ja1umi/MUTIF1613Project/README.md

# MUTIF1613Project
This project aims to build a vintage PANAFACOM's 16-bit MN1613-based computer. All the project-related files are available here.
