ja1umi/MUTIF1613Project/mutif1613/mutif1613_schematic.pdf

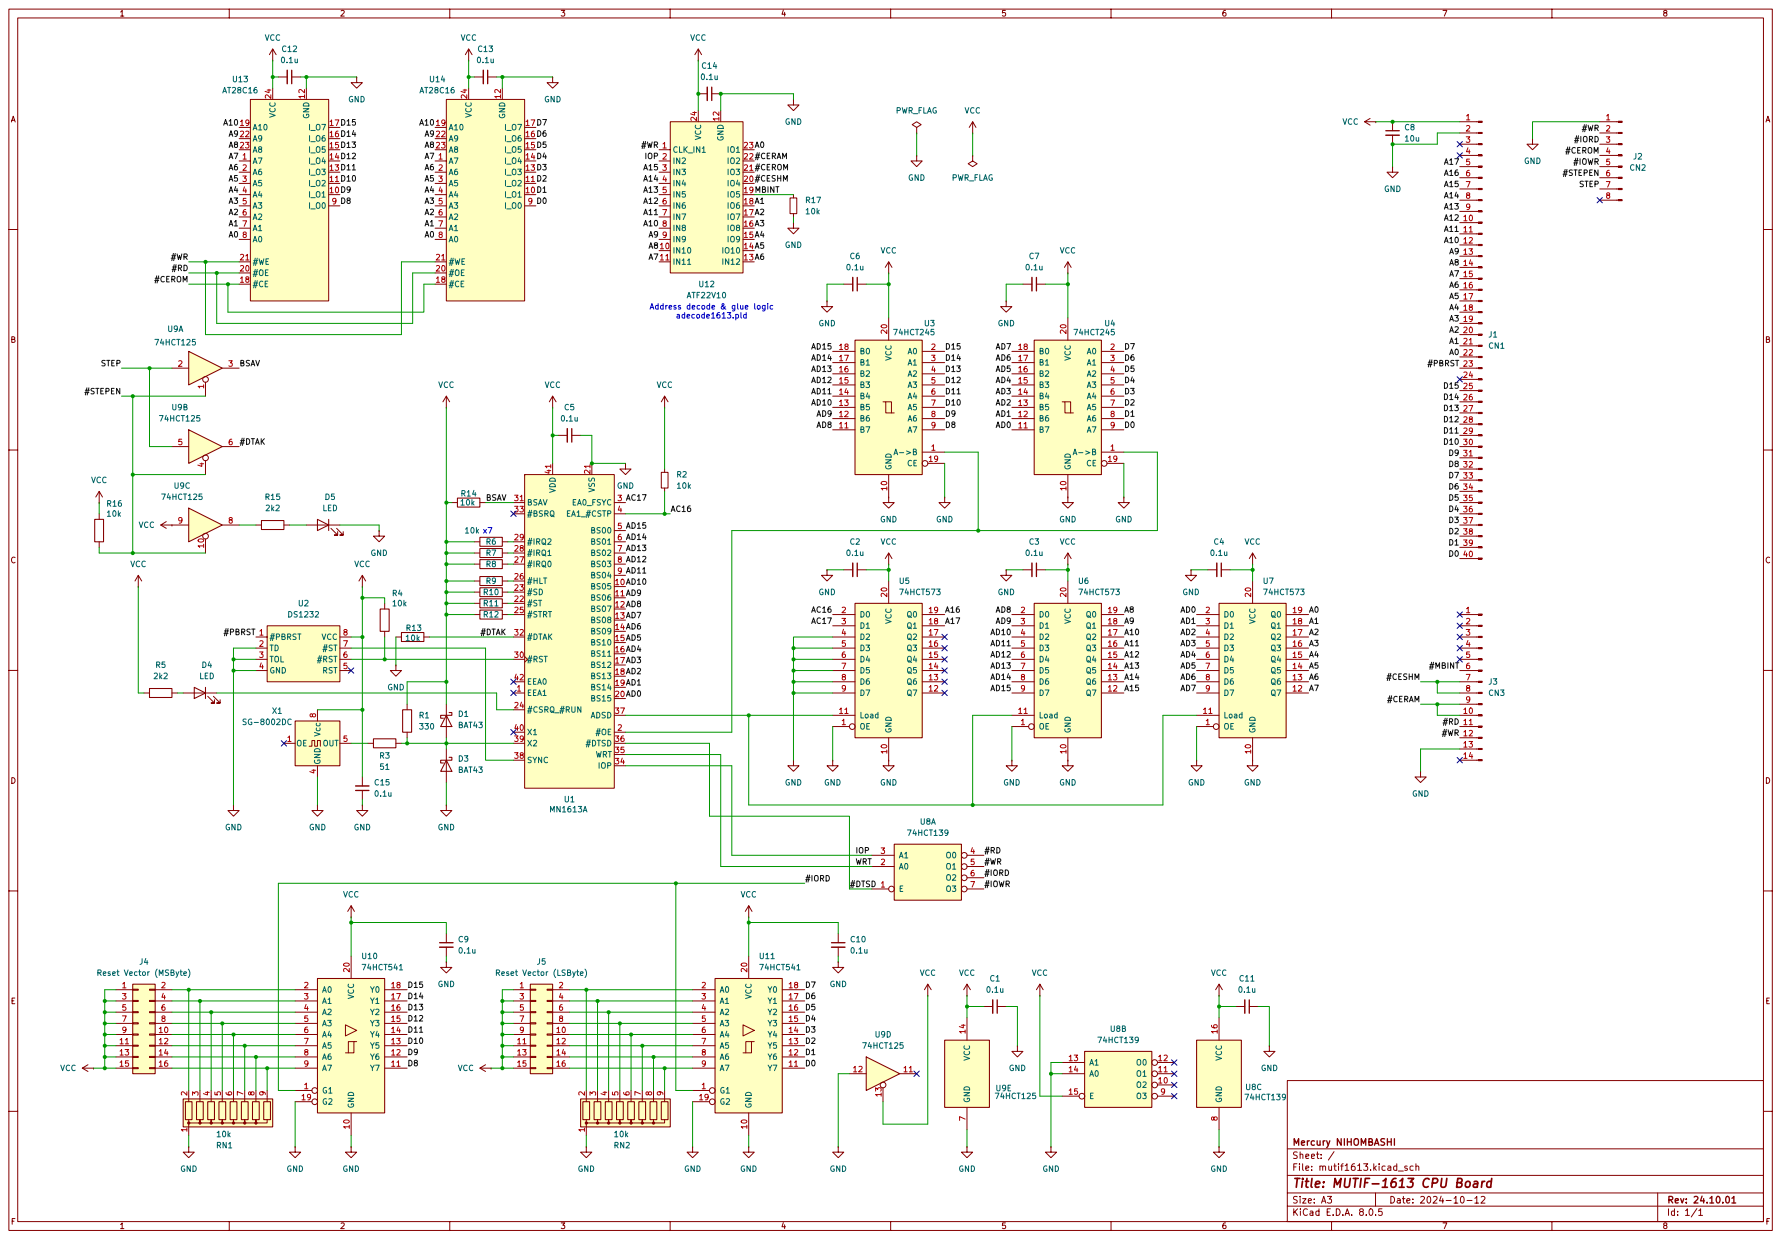
[picture p1: page 1]
