ja1umi/MUTIF1613Project/7segled/7segled-24_11_2.pdf

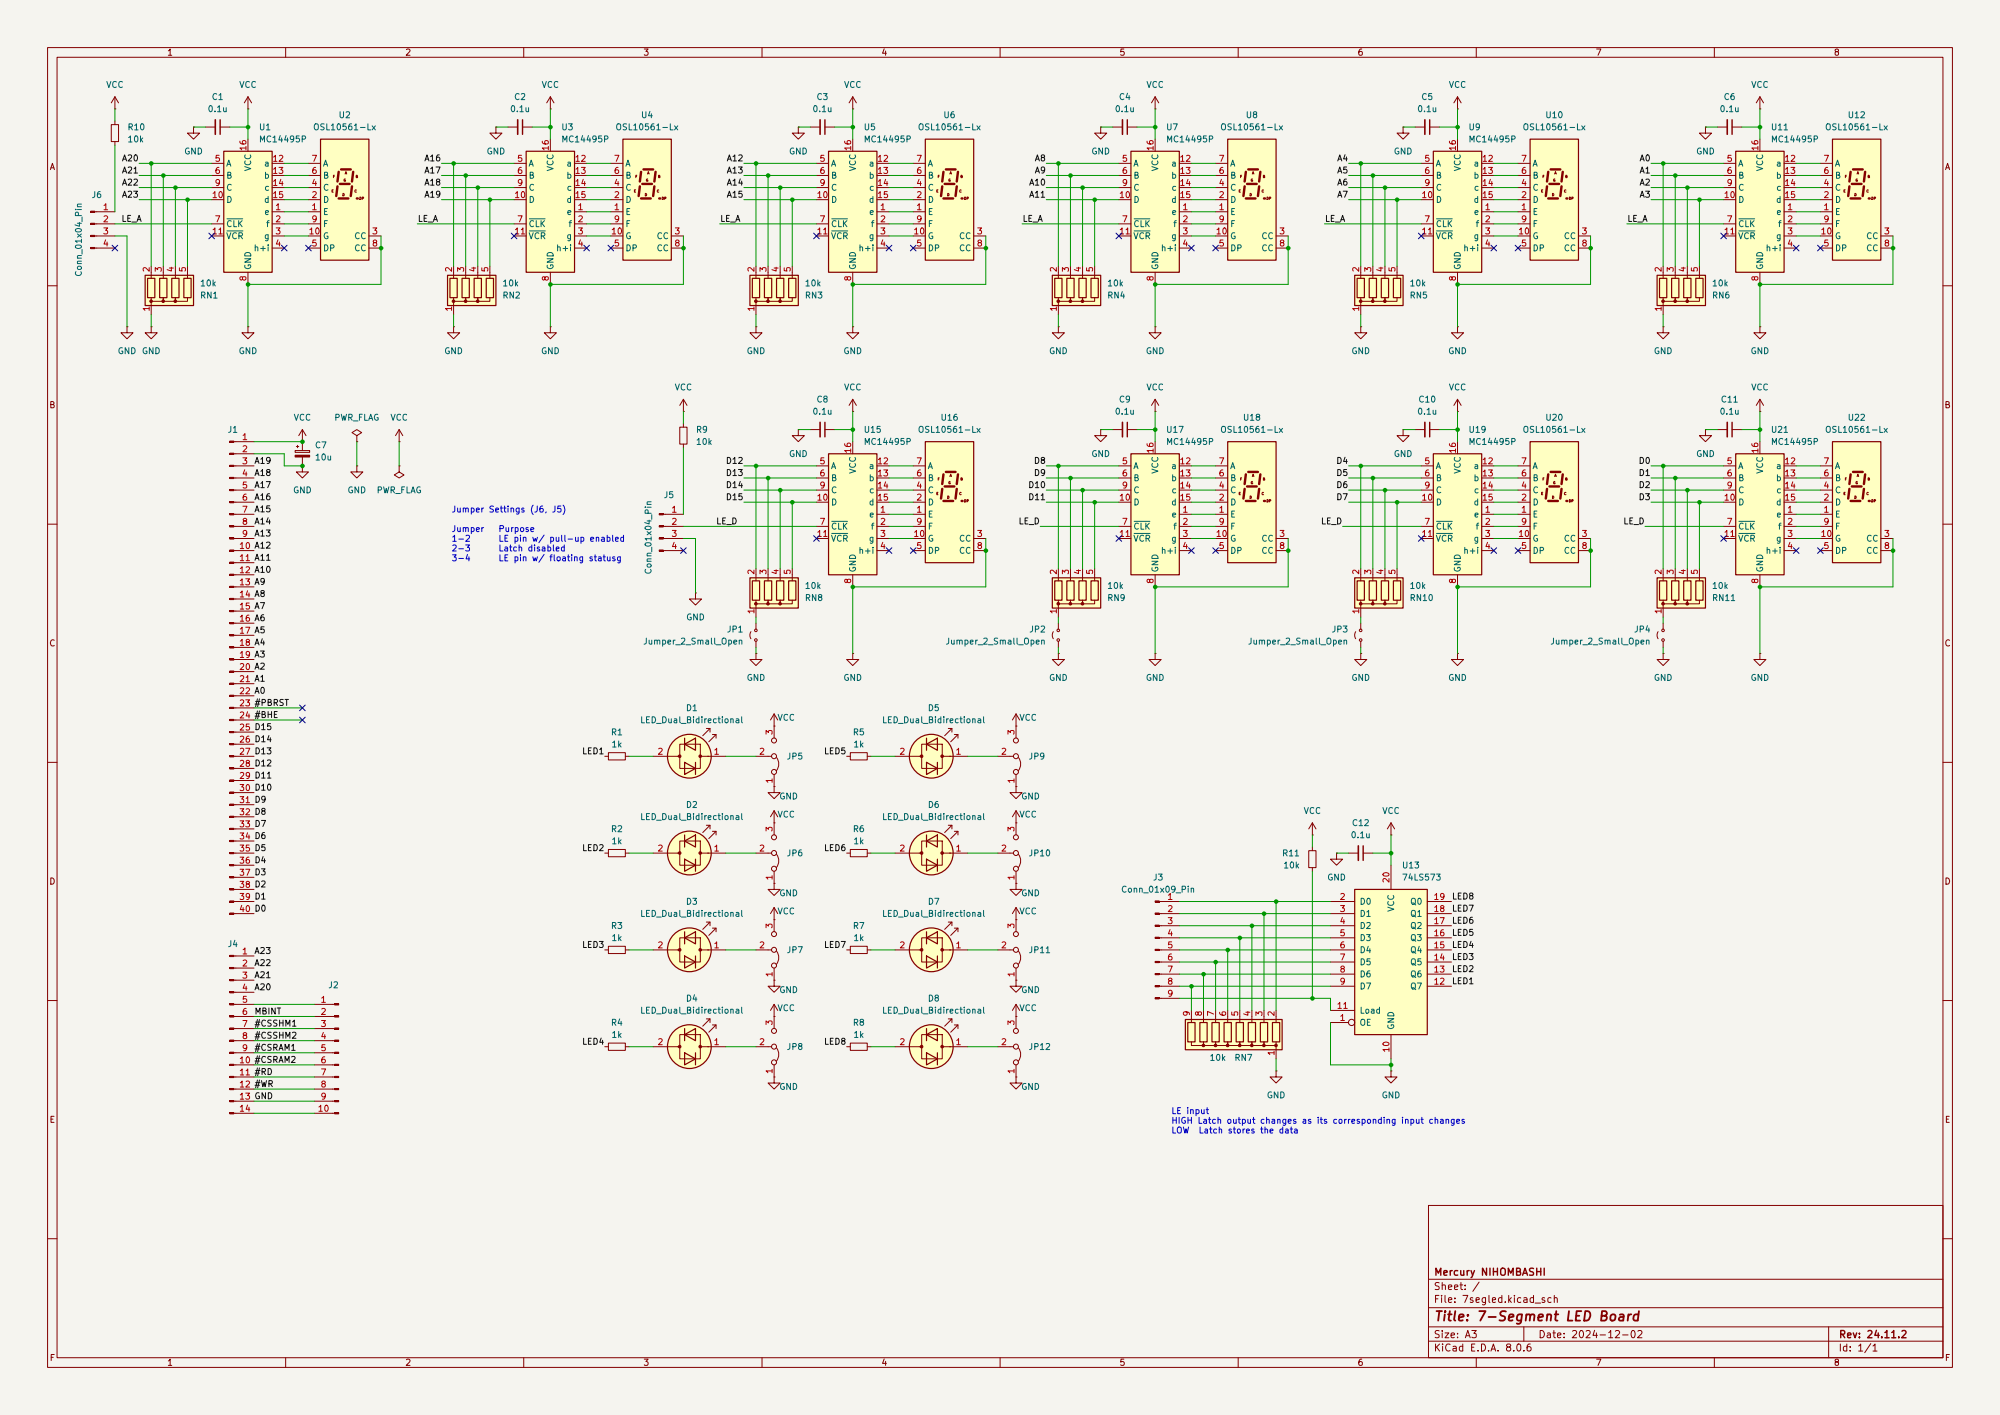
[picture p2: page 1]
