ja1umi/MUTIF1613Project/backplane5/mutif-backplane5-24_11_2.pdf

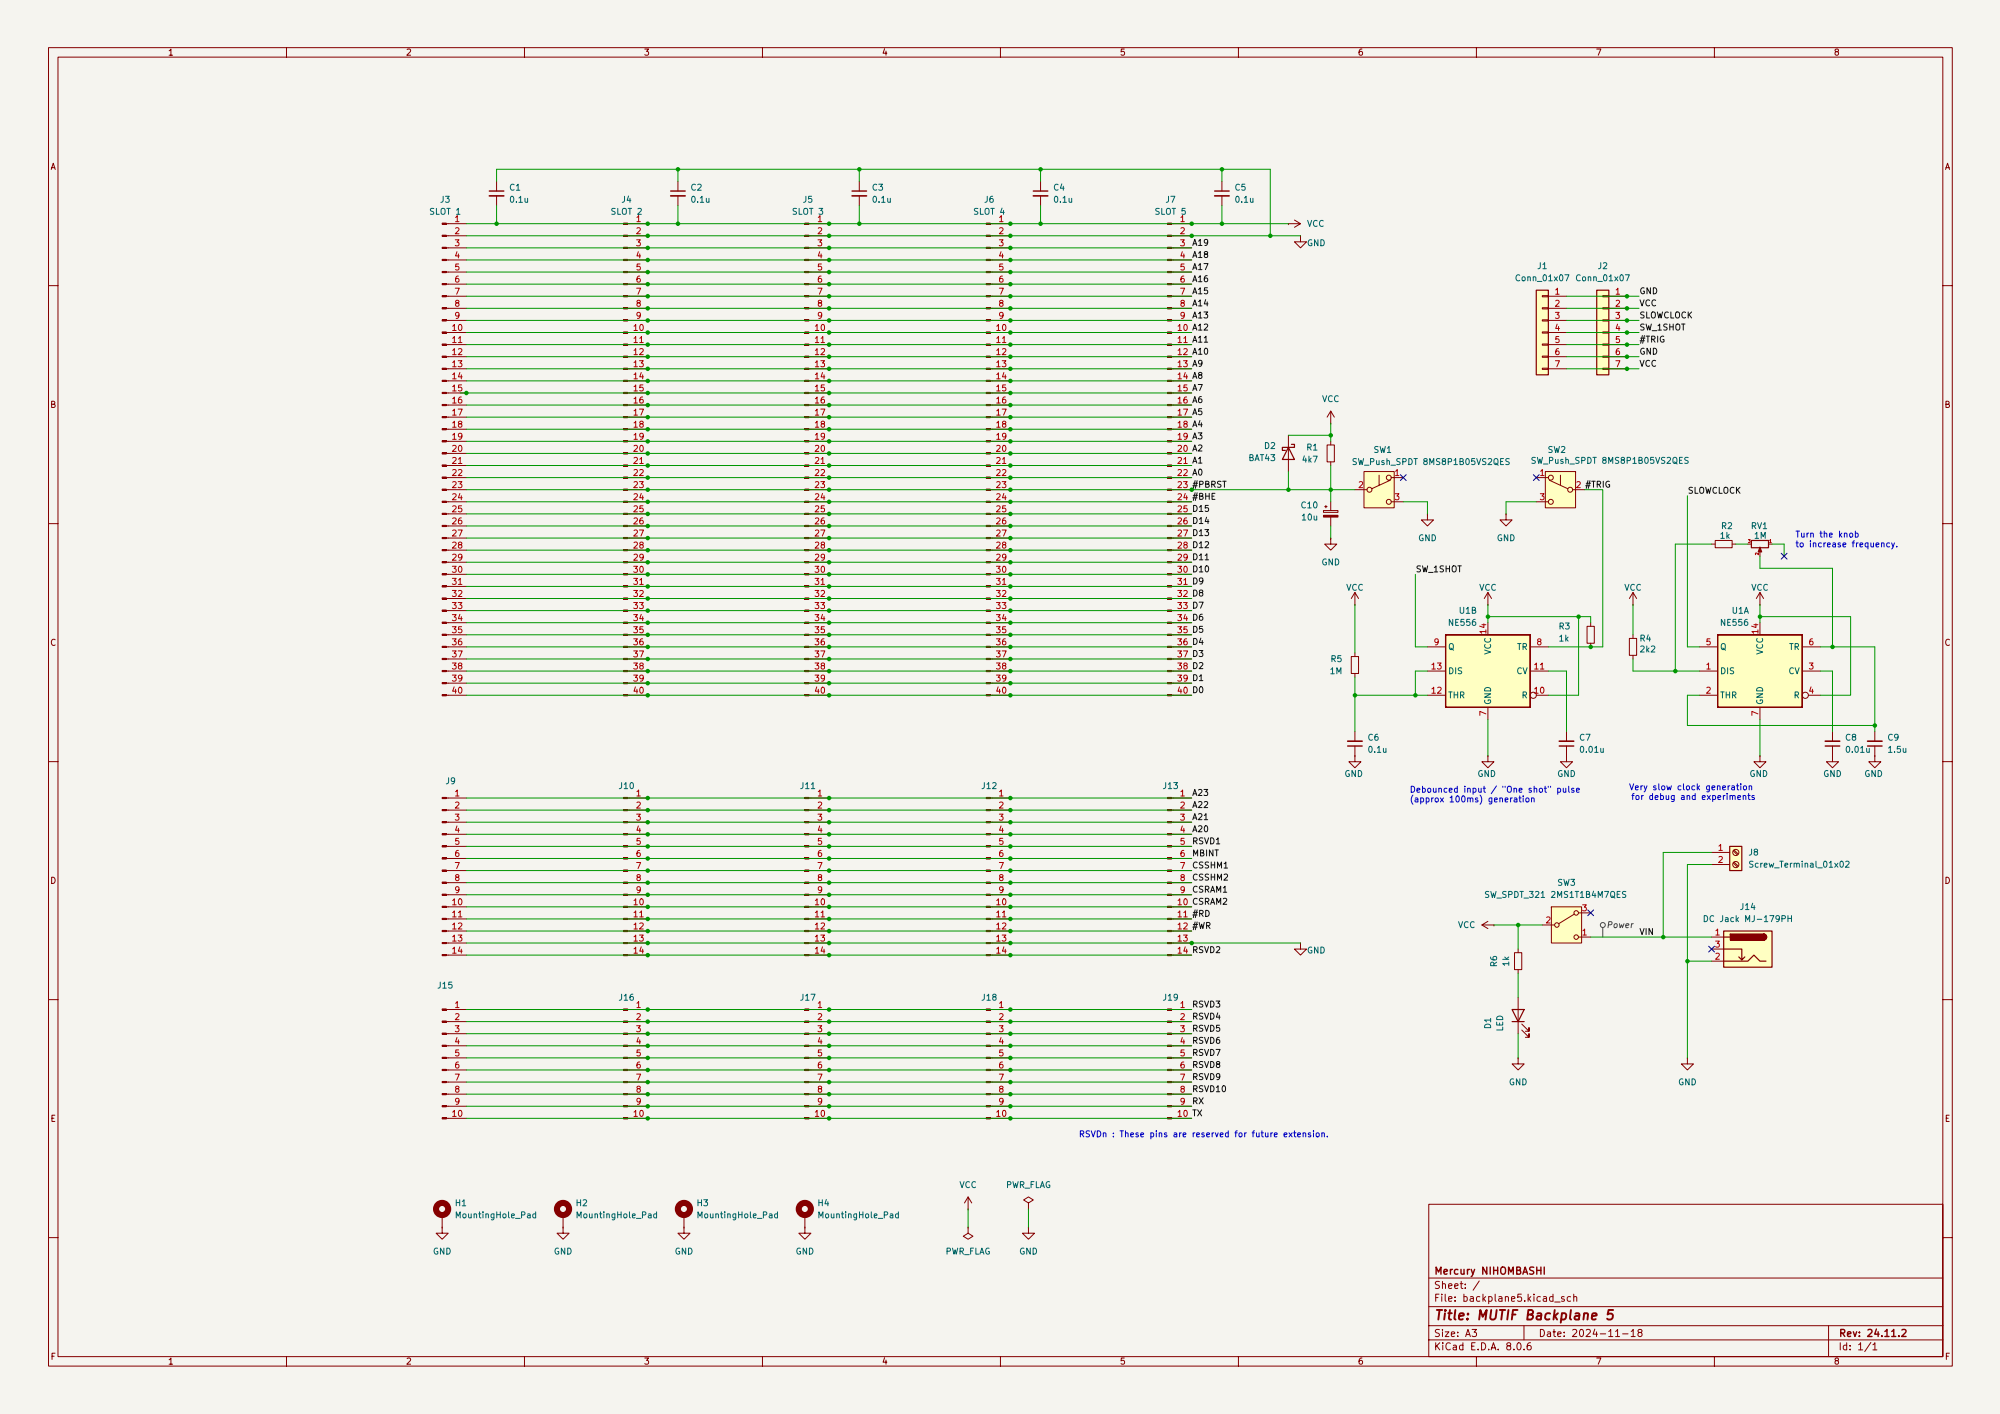
[picture p3: page 1]
