ja1umi/MUTIF1613Project/dpram7134/dpram7134-24_11_1.pdf

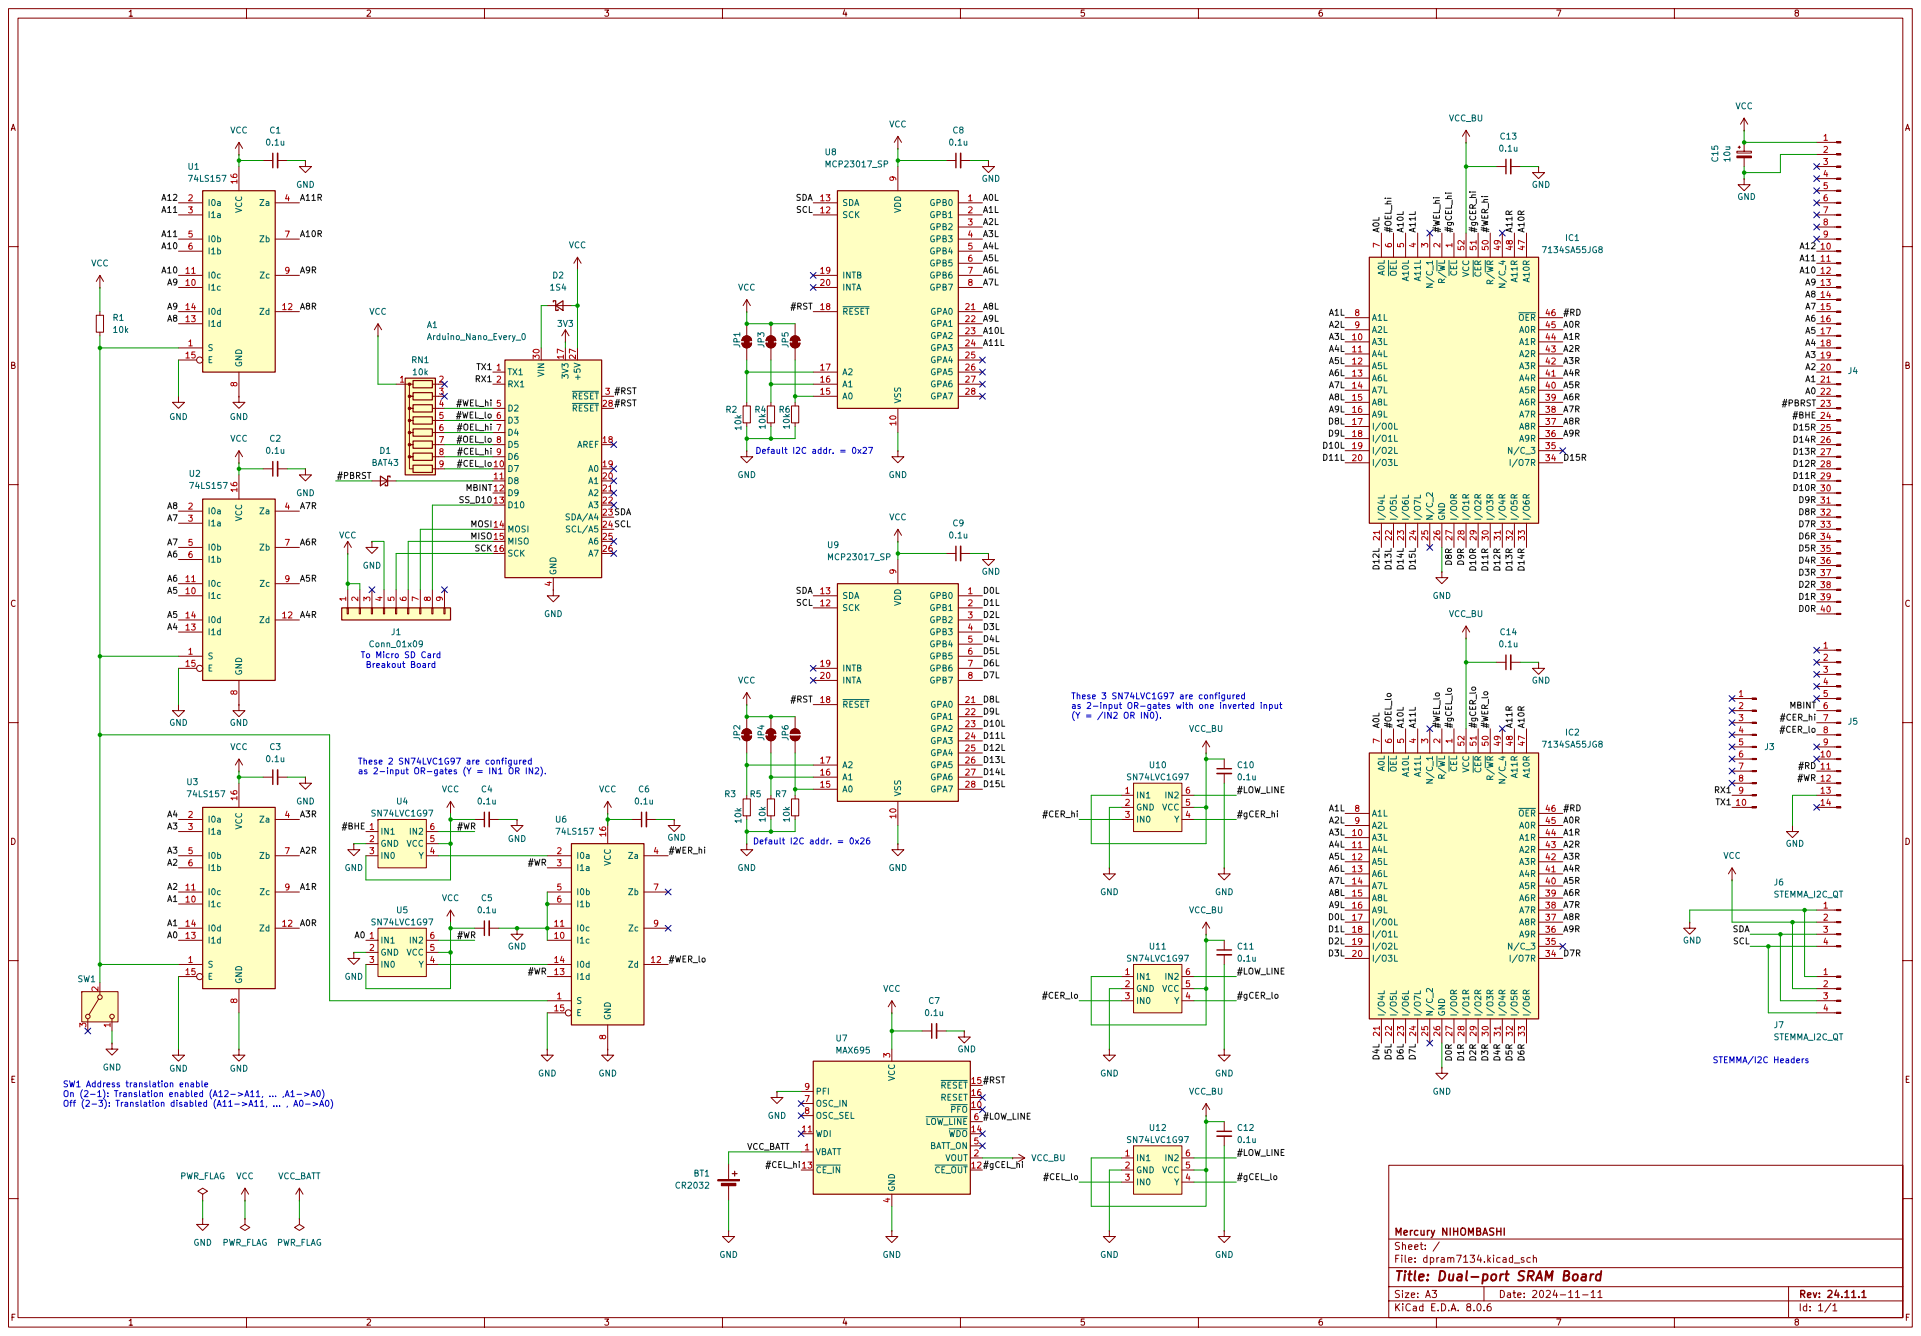
[picture p4: page 1]
