ja1umi/MUTIF1613Project/backplane5/backplane5.kicad_pcb

## KiCad design backplane5/backplane5.kicad_pcb (2024-12-31)

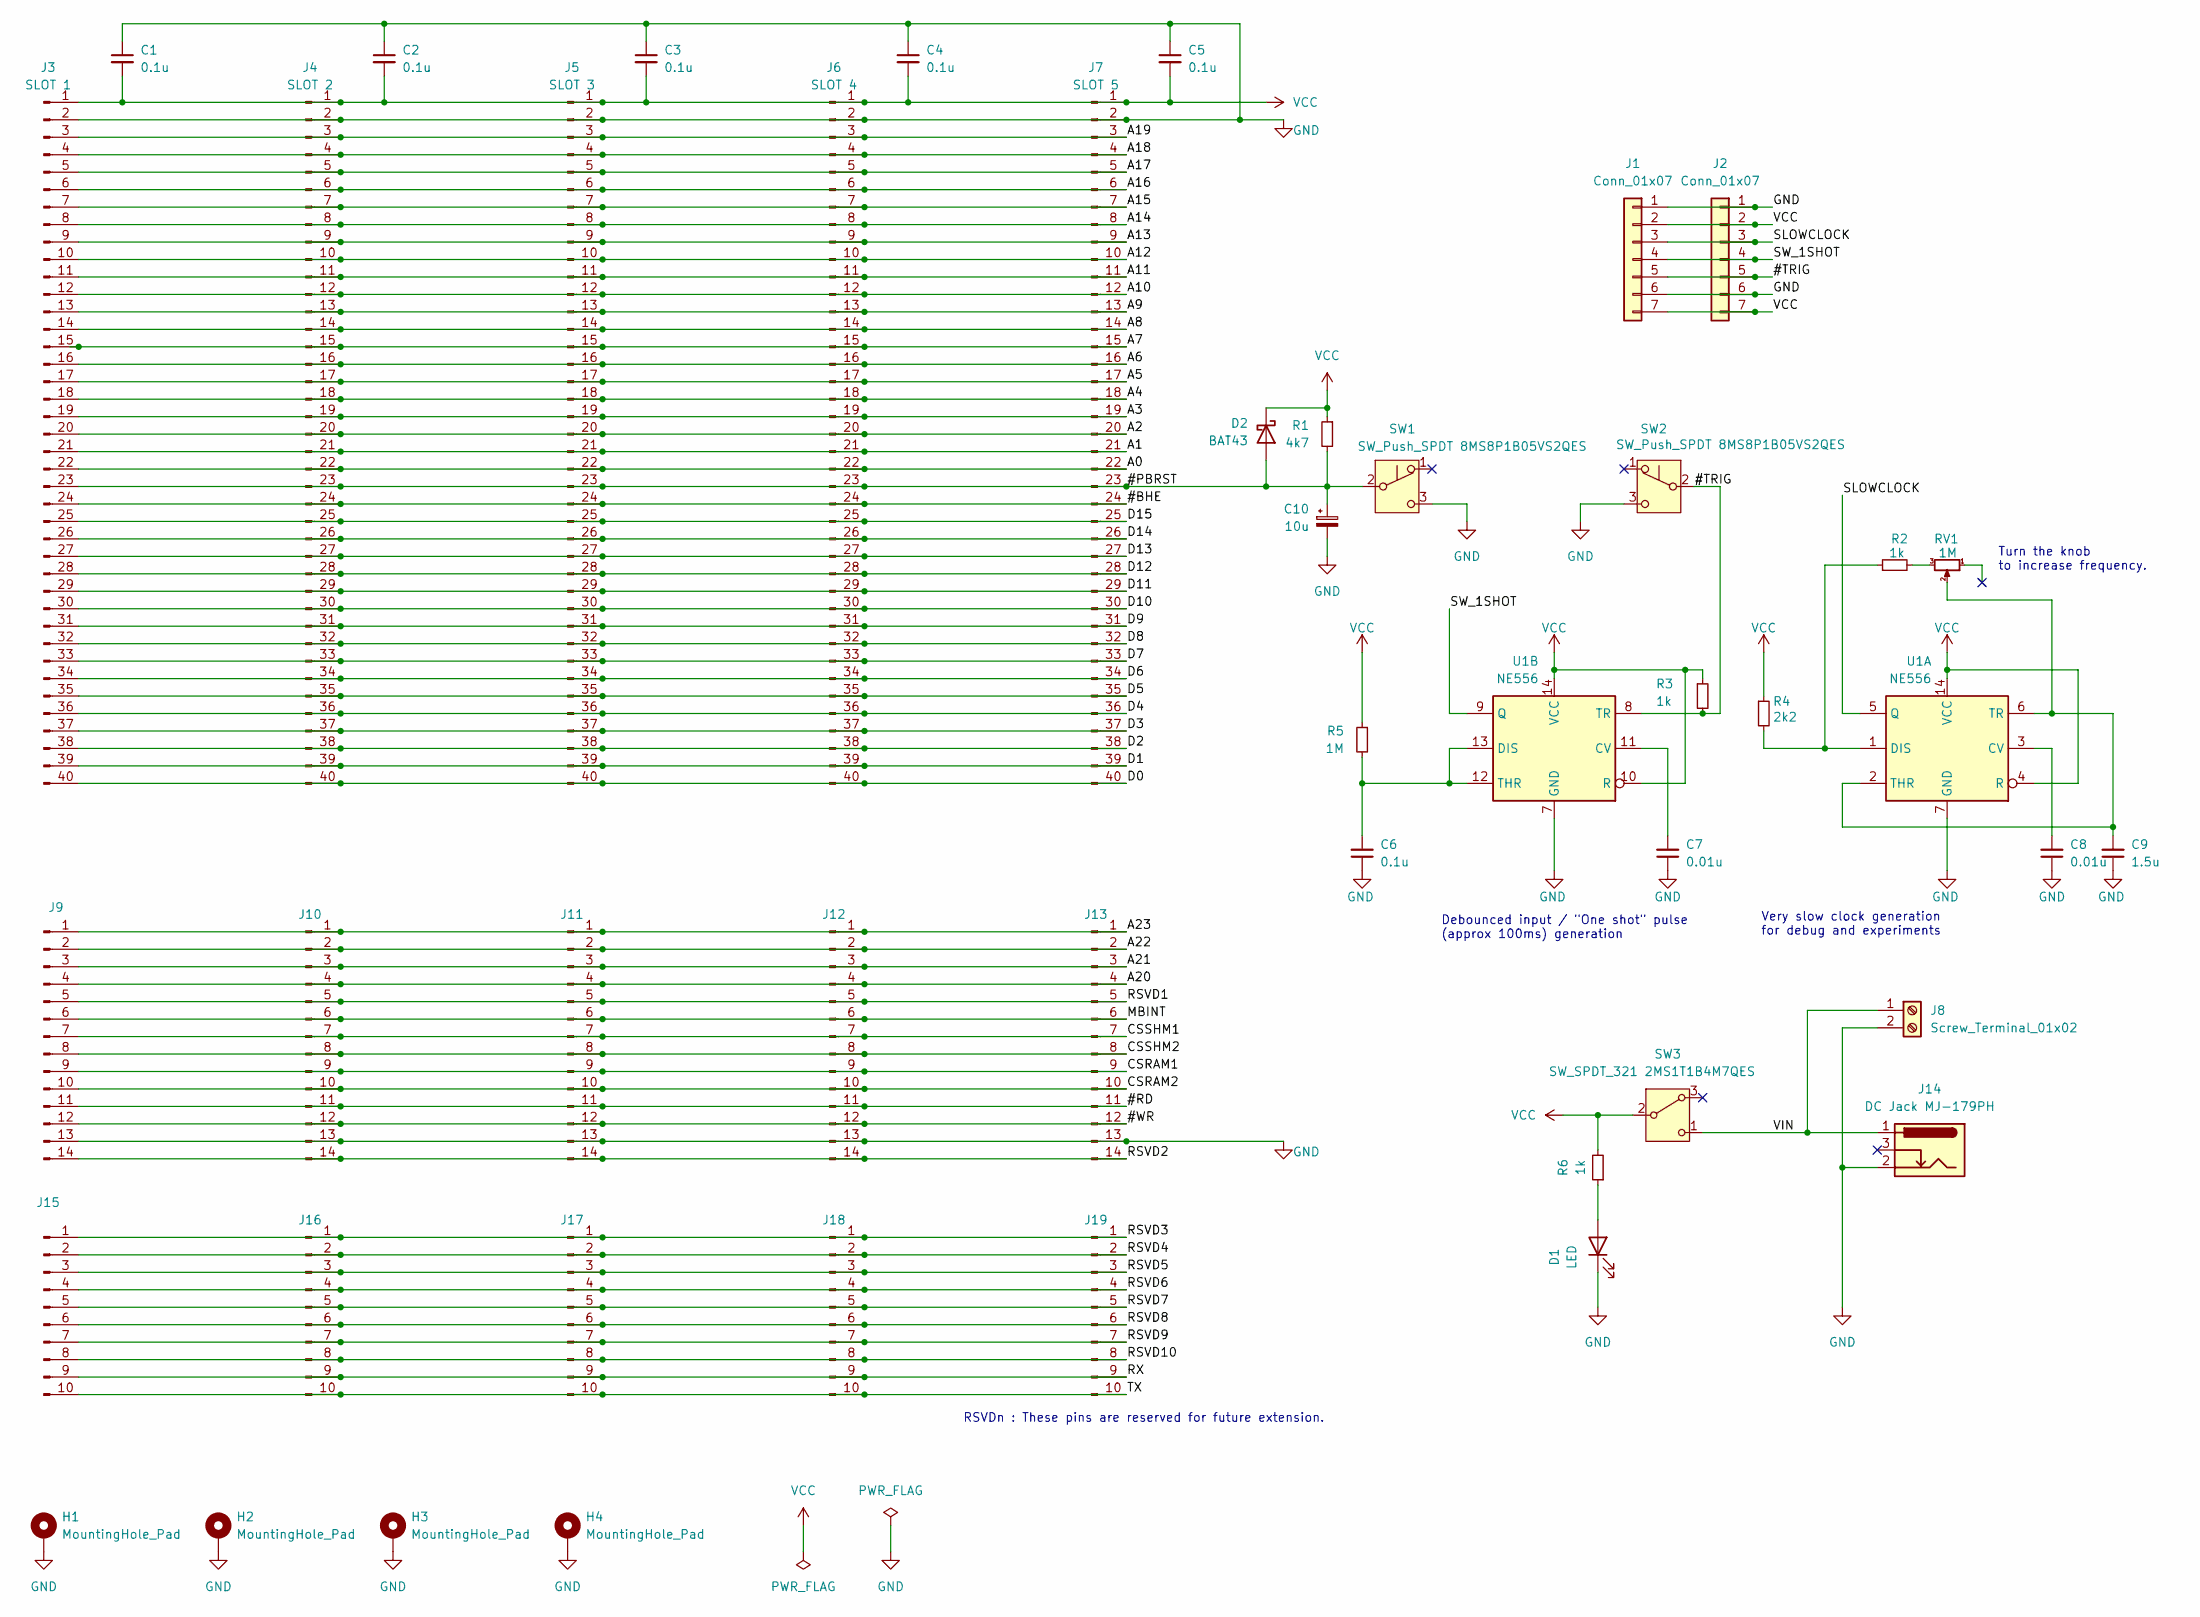
[picture p5: schematic backplane5.kicad_sch, MUTIF Backplane 5]

Parts:
C1, C2, C3, C4, C5, C6: 0.1u; C_Disc_D5.0mm_W2.5mm_P2.50mm
C7, C8: 0.01u; C_Disc_D5.0mm_W2.5mm_P2.50mm
C9: 1.5u; C_Disc_D5.0mm_W2.5mm_P5.00mm
C10: 10u; CP_Radial_D5.0mm_P2.50mm
D1: LED; LED_D5.0mm
D2: BAT43; D_DO-35_SOD27_P7.62mm_Horizontal
H1, H2, H3, H4: MountingHole_Pad; MountingHole_3.2mm_M3_Pad
J1, J2: Conn_01x07; PinHeader_1x07_P2.54mm_Vertical
J3: SLOT 1; PinHeader_1x40_P2.54mm_Vertical
J4: SLOT 2; PinHeader_1x40_P2.54mm_Vertical
J5: SLOT 3; PinHeader_1x40_P2.54mm_Vertical
J6: SLOT 4; PinHeader_1x40_P2.54mm_Vertical
J7: SLOT 5; PinHeader_1x40_P2.54mm_Vertical
J8: Screw_Terminal_01x02; TerminalBlock_Phoenix_MKDS-1,5-2-5.08_1x02_P5.08mm_Horizont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
J9, J10, J11, J12, J13: Conn_01x14_Pin; PinHeader_1x14_P2.54mm_Vertical
J14: DC Jack MJ-179PH; MJ-179PH
J15, J16, J17, J18, J19: Conn_01x10_Pin; PinHeader_1x10_P2.54mm_Vertical
R1: 4k7; R_Axial_DIN0204_L3.6mm_D1.6mm_P7.62mm_Horizontal
R2, R3, R6: 1k; R_Axial_DIN0204_L3.6mm_D1.6mm_P7.62mm_Horizontal
R4: 2k2; R_Axial_DIN0204_L3.6mm_D1.6mm_P7.62mm_Horizontal
R5: 1M; R_Axial_DIN0204_L3.6mm_D1.6mm_P7.62mm_Horizontal
RV1: 1M; Potentiometer_Bourns_3296W_Vertical
SW1, SW2: SW_Push_SPDT 8MS8P1B05VS2QES; 8MSP0340
SW3: SW_SPDT_321 2MS1T1B4M7QES; 2MS1T1B4M7QES
U1: NE556; DIP-14_W7.62mm_LongPads

Connections:
/#BHE: J3.24, J4.24, J5.24, J6.24, J7.24
/#PBRST: C10.1, D2.2 (A), J3.23, J4.23, J5.23, J6.23, J7.23, R1.2, SW1.2 (B)
/#RD: J9.11, J10.11, J11.11, J12.11, J13.11
/#TRIG: J1.5, J2.5, R3.2, SW2.2 (B), U1.8 (TR)
/#WR: J9.12, J10.12, J11.12, J12.12, J13.12
/A0: J3.22, J4.22, J5.22, J6.22, J7.22
/A1: J3.21, J4.21, J5.21, J6.21, J7.21
/A2: J3.20, J4.20, J5.20, J6.20, J7.20
/A3: J3.19, J4.19, J5.19, J6.19, J7.19
/A4: J3.18, J4.18, J5.18, J6.18, J7.18
/A5: J3.17, J4.17, J5.17, J6.17, J7.17
/A6: J3.16, J4.16, J5.16, J6.16, J7.16
/A7: J3.15, J4.15, J5.15, J6.15, J7.15
/A8: J3.14, J4.14, J5.14, J6.14, J7.14
/A9: J3.13, J4.13, J5.13, J6.13, J7.13
/A10: J3.12, J4.12, J5.12, J6.12, J7.12
/A11: J3.11, J4.11, J5.11, J6.11, J7.11
/A12: J3.10, J4.10, J5.10, J6.10, J7.10
/A13: J3.9, J4.9, J5.9, J6.9, J7.9
/A14: J3.8, J4.8, J5.8, J6.8, J7.8
/A15: J3.7, J4.7, J5.7, J6.7, J7.7
/A16: J3.6, J4.6, J5.6, J6.6, J7.6
/A17: J3.5, J4.5, J5.5, J6.5, J7.5
/A18: J3.4, J4.4, J5.4, J6.4, J7.4
/A19: J3.3, J4.3, J5.3, J6.3, J7.3
/A20: J9.4, J10.4, J11.4, J12.4, J13.4
/A21: J9.3, J10.3, J11.3, J12.3, J13.3
/A22: J9.2, J10.2, J11.2, J12.2, J13.2
/A23: J9.1, J10.1, J11.1, J12.1, J13.1
/CSRAM1: J9.9, J10.9, J11.9, J12.9, J13.9
/CSRAM2: J9.10, J10.10, J11.10, J12.10, J13.10
/CSSHM1: J9.7, J10.7, J11.7, J12.7, J13.7
/CSSHM2: J9.8, J10.8, J11.8, J12.8, J13.8
/D0: J3.40, J4.40, J5.40, J6.40, J7.40
/D1: J3.39, J4.39, J5.39, J6.39, J7.39
/D2: J3.38, J4.38, J5.38, J6.38, J7.38
/D3: J3.37, J4.37, J5.37, J6.37, J7.37
/D4: J3.36, J4.36, J5.36, J6.36, J7.36
/D5: J3.35, J4.35, J5.35, J6.35, J7.35
/D6: J3.34, J4.34, J5.34, J6.34, J7.34
/D7: J3.33, J4.33, J5.33, J6.33, J7.33
/D8: J3.32, J4.32, J5.32, J6.32, J7.32
/D9: J3.31, J4.31, J5.31, J6.31, J7.31
/D10: J3.30, J4.30, J5.30, J6.30, J7.30
/D11: J3.29, J4.29, J5.29, J6.29, J7.29
/D12: J3.28, J4.28, J5.28, J6.28, J7.28
/D13: J3.27, J4.27, J5.27, J6.27, J7.27
/D14: J3.26, J4.26, J5.26, J6.26, J7.26
/D15: J3.25, J4.25, J5.25, J6.25, J7.25
/MBINT: J9.6, J10.6, J11.6, J12.6, J13.6
/RSVD1: J9.5, J10.5, J11.5, J12.5, J13.5
/RSVD2: J9.14, J10.14, J11.14, J12.14, J13.14
/RSVD3: J15.1, J16.1, J17.1, J18.1, J19.1
/RSVD4: J15.2, J16.2, J17.2, J18.2, J19.2
/RSVD5: J15.3, J16.3, J17.3, J18.3, J19.3
/RSVD6: J15.4, J16.4, J17.4, J18.4, J19.4
/RSVD7: J15.5, J16.5, J17.5, J18.5, J19.5
/RSVD8: J15.6, J16.6, J17.6, J18.6, J19.6
/RSVD9: J15.7, J16.7, J17.7, J18.7, J19.7
/RSVD10: J15.8, J16.8, J17.8, J18.8, J19.8
/RX: J15.9, J16.9, J17.9, J18.9, J19.9
/SLOWCLOCK: J1.3, J2.3, U1.5 (Q)
/SW_1SHOT: J1.4, J2.4, U1.9 (Q)
/TX: J15.10, J16.10, J17.10, J18.10, J19.10
/VIN: J8.1, J14.1, SW3.1 (C)
GND: C1.1, C2.1, C3.1, C4.1, C5.1, C6.1, C7.1, C8.1, C9.1, C10.2, D1.1 (K), H1.1, H2.1, H3.1, H4.1, J1.1, J1.6, J2.1, J2.6, J3.2, J4.2, J5.2, J6.2, J7.2, J8.2, J9.13, J10.13, J11.13, J12.13, J13.13, J14.2, SW1.3 (C), SW2.3 (C), U1.7 (GND)
unnamed: D1.2 (A), R6.1
unnamed: R2.2, RV1.3
unnamed: C8.2, U1.3 (CV)
unnamed: R2.1, R4.2, U1.1 (DIS)
unnamed: C9.2, RV1.2, U1.2 (THR), U1.6 (TR)
unnamed: C7.2, U1.11 (CV)
unnamed: C6.2, R5.2, U1.12 (THR), U1.13 (DIS)
VCC: C1.2, C2.2, C3.2, C4.2, C5.2, D2.1 (K), J1.2, J1.7, J2.2, J2.7, J3.1, J4.1, J5.1, J6.1, J7.1, R1.1, R3.1, R4.1, R5.1, R6.2, SW3.2 (B), U1.4 (R), U1.10 (R), U1.14 (VCC)

Notes on the sheet:
RSVDn : These pins are reserved for future extension.
Turn the knob to increase frequency.
Very slow clock generation for debug and experiments
Debounced input / "One shot" pulse (approx 100ms) generation

Board: 2 copper layers, 46 parts (0 on the bottom side), 74 nets, no tracks yet.
