ja1umi/MUTIF1613Project/dpram7134/dpram7134.kicad_pcb

## KiCad design dpram7134/dpram7134.kicad_pcb (2024-12-31)

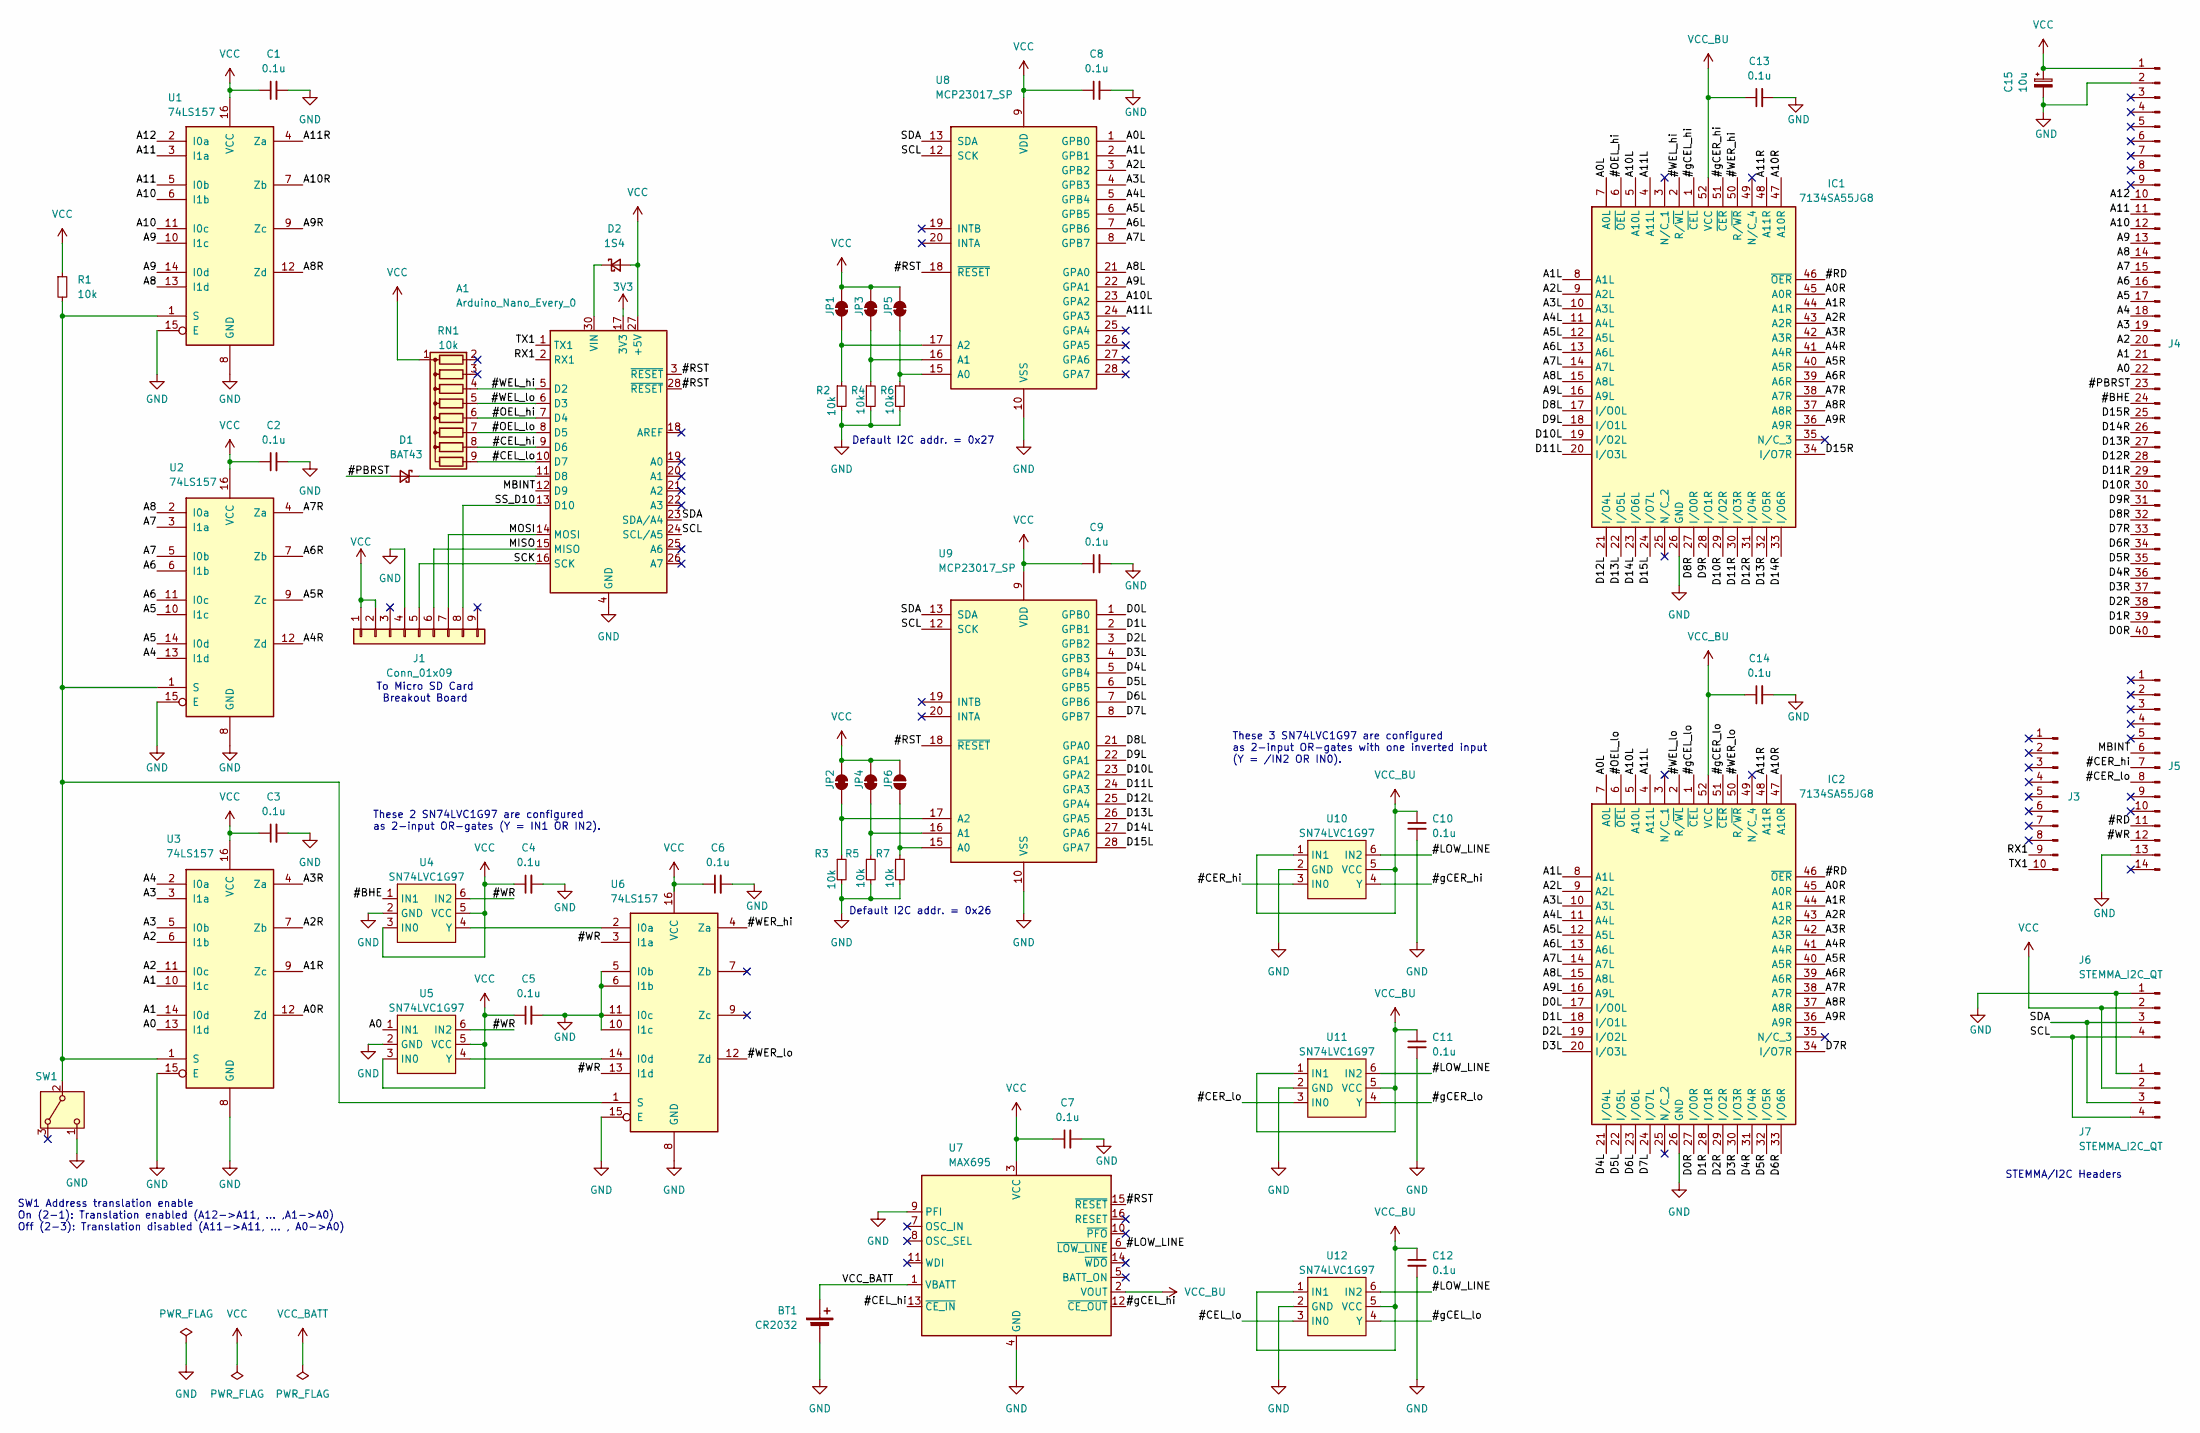
[picture p6: schematic dpram7134.kicad_sch, Dual-port SRAM Board]

Parts:
A1: Arduino_Nano_Every_0; Arduino_Nano
BT1: CR2032; CH243-2032LF
C1, C2, C3, C4, C5, C6, C7, C8, C9, C10, C11, C12, C13, C14: 0.1u; C_Disc_D5.0mm_W2.5mm_P5.00mm
C15: 10u; CP_Radial_D5.0mm_P2.50mm
D1: BAT43; D_DO-35_SOD27_P7.62mm_Horizontal
D2: 1S4; D_DO-35_SOD27_P7.62mm_Horizontal
IC1, IC2: 7134SA55JG8; PLCC-52_THT-Socket; Mouser Part Number 972-7134SA55JG8
J1: Conn_01x09; PinHeader_1x09_P2.54mm_Vertical
J3: Conn_01x10_Pin; PinHeader_1x10_P2.54mm_Vertical
J4: Conn_01x40_Pin; PinHeader_1x40_P2.54mm_Vertical
J5: Conn_01x14_Pin; PinHeader_1x14_P2.54mm_Vertical
J6, J7: STEMMA_I2C_QT; JST_SH_SM04B-SRSS-TB_1x04-1MP_P1.00mm_Horizontal
JP1, JP2, JP3, JP4, JP5: SolderJumper_2_Bridged; SolderJumper-2_P1.3mm_Open_Pad1.0x1.5mm
JP6: SolderJumper_2_Open; SolderJumper-2_P1.3mm_Open_Pad1.0x1.5mm
R1, R2, R3, R4, R5, R6, R7: 10k; R_Axial_DIN0207_L6.3mm_D2.5mm_P7.62mm_Horizontal
RN1: 10k; R_Array_SIP9
SW1: SW_SPDT_321; PinHeader_1x03_P2.54mm_Vertical
U1, U2, U3, U6: 74LS157; DIP-16_W7.62mm_LongPads
U4, U5, U10, U11, U12: SN74LVC1G97; SOT-23-6
U7: MAX695; DIP-16_W7.62mm_LongPads
U8, U9: MCP23017_SP; DIP-28_W7.62mm_LongPads

Connections:
3V3: A1.17 (3V3)
/#BHE: J4.24, U4.1 (IN1)
/#CEL_hi: A1.9 (D6), RN1.8 (R7), U7.13 (~CE_IN)
/#CEL_lo: A1.10 (D7), RN1.9 (R8), U12.3 (IN0)
/#CER_hi: J5.7, U10.3 (IN0)
/#CER_lo: J5.8, U11.3 (IN0)
/#LOW_LINE: U7.6 (~LOW_LINE), U10.6 (IN2), U11.6 (IN2), U12.6 (IN2)
/#OEL_hi: A1.7 (D4), IC1.6 (~OEL), RN1.6 (R5)
/#OEL_lo: A1.8 (D5), IC2.6 (~OEL), RN1.7 (R6)
/#PBRST: D1.2 (A), J4.23
/#RD: IC1.46 (~OER), IC2.46 (~OER), J5.11
/#RST: A1.3 (~RESET), A1.28 (~RESET), U7.15 (~RESET), U8.18 (~RESET), U9.18 (~RESET)
/#WEL_hi: A1.5 (D2), IC1.2 (R/~WL), RN1.4 (R3)
/#WEL_lo: A1.6 (D3), IC2.2 (R/~WL), RN1.5 (R4)
/#WER_hi: IC1.50 (R/~WR), U6.4 (Za)
/#WER_lo: IC2.50 (R/~WR), U6.12 (Zd)
/#WR: J5.12, U4.6 (IN2), U5.6 (IN2), U6.3 (I1a), U6.13 (I1d)
/#gCEL_hi: IC1.1 (~CEL), U7.12 (~CE_OUT)
/#gCEL_lo: IC2.1 (~CEL), U12.4 (Y)
/#gCER_hi: IC1.51 (~CER), U10.4 (Y)
/#gCER_lo: IC2.51 (~CER), U11.4 (Y)
/A0: J4.22, U3.13 (I1d), U5.1 (IN1)
/A0L: IC1.7 (A0L), IC2.7 (A0L), U8.1 (GPB0)
/A0R: IC1.45 (A0R), IC2.45 (A0R), U3.12 (Zd)
/A1: J4.21, U3.10 (I1c), U3.14 (I0d)
/A1L: IC1.8 (A1L), IC2.8 (A1L), U8.2 (GPB1)
/A1R: IC1.44 (A1R), IC2.44 (A1R), U3.9 (Zc)
/A2: J4.20, U3.6 (I1b), U3.11 (I0c)
/A2L: IC1.9 (A2L), IC2.9 (A2L), U8.3 (GPB2)
/A2R: IC1.43 (A2R), IC2.43 (A2R), U3.7 (Zb)
/A3: J4.19, U3.3 (I1a), U3.5 (I0b)
/A3L: IC1.10 (A3L), IC2.10 (A3L), U8.4 (GPB3)
/A3R: IC1.42 (A3R), IC2.42 (A3R), U3.4 (Za)
/A4: J4.18, U2.13 (I1d), U3.2 (I0a)
/A4L: IC1.11 (A4L), IC2.11 (A4L), U8.5 (GPB4)
/A4R: IC1.41 (A4R), IC2.41 (A4R), U2.12 (Zd)
/A5: J4.17, U2.10 (I1c), U2.14 (I0d)
/A5L: IC1.12 (A5L), IC2.12 (A5L), U8.6 (GPB5)
/A5R: IC1.40 (A5R), IC2.40 (A5R), U2.9 (Zc)
/A6: J4.16, U2.6 (I1b), U2.11 (I0c)
/A6L: IC1.13 (A6L), IC2.13 (A6L), U8.7 (GPB6)
/A6R: IC1.39 (A6R), IC2.39 (A6R), U2.7 (Zb)
/A7: J4.15, U2.3 (I1a), U2.5 (I0b)
/A7L: IC1.14 (A7L), IC2.14 (A7L), U8.8 (GPB7)
/A7R: IC1.38 (A7R), IC2.38 (A7R), U2.4 (Za)
/A8: J4.14, U1.13 (I1d), U2.2 (I0a)
/A8L: IC1.15 (A8L), IC2.15 (A8L), U8.21 (GPA0)
/A8R: IC1.37 (A8R), IC2.37 (A8R), U1.12 (Zd)
/A9: J4.13, U1.10 (I1c), U1.14 (I0d)
/A9L: IC1.16 (A9L), IC2.16 (A9L), U8.22 (GPA1)
/A9R: IC1.36 (A9R), IC2.36 (A9R), U1.9 (Zc)
/A10: J4.12, U1.6 (I1b), U1.11 (I0c)
/A10L: IC1.5 (A10L), IC2.5 (A10L), U8.23 (GPA2)
/A10R: IC1.47 (A10R), IC2.47 (A10R), U1.7 (Zb)
/A11: J4.11, U1.3 (I1a), U1.5 (I0b)
/A11L: IC1.4 (A11L), IC2.4 (A11L), U8.24 (GPA3)
/A11R: IC1.48 (A11R), IC2.48 (A11R), U1.4 (Za)
/A12: J4.10, U1.2 (I0a)
/D0L: IC2.17 (I/O0L), U9.1 (GPB0)
/D0R: IC2.27 (I/O0R), J4.40
/D1L: IC2.18 (I/O1L), U9.2 (GPB1)
/D1R: IC2.28 (I/O1R), J4.39
/D2L: IC2.19 (I/O2L), U9.3 (GPB2)
/D2R: IC2.29 (I/O2R), J4.38
/D3L: IC2.20 (I/O3L), U9.4 (GPB3)
/D3R: IC2.30 (I/O3R), J4.37
/D4L: IC2.21 (I/O4L), U9.5 (GPB4)
/D4R: IC2.31 (I/O4R), J4.36
/D5L: IC2.22 (I/O5L), U9.6 (GPB5)
/D5R: IC2.32 (I/O5R), J4.35
/D6L: IC2.23 (I/O6L), U9.7 (GPB6)
/D6R: IC2.33 (I/O6R), J4.34
/D7L: IC2.24 (I/O7L), U9.8 (GPB7)
/D7R: IC2.34 (I/O7R), J4.33
/D8L: IC1.17 (I/O0L), U9.21 (GPA0)
/D8R: IC1.27 (I/O0R), J4.32
/D9L: IC1.18 (I/O1L), U9.22 (GPA1)
/D9R: IC1.28 (I/O1R), J4.31
/D10L: IC1.19 (I/O2L), U9.23 (GPA2)
/D10R: IC1.29 (I/O2R), J4.30
/D11L: IC1.20 (I/O3L), U9.24 (GPA3)
/D11R: IC1.30 (I/O3R), J4.29
/D12L: IC1.21 (I/O4L), U9.25 (GPA4)
/D12R: IC1.31 (I/O4R), J4.28
/D13L: IC1.22 (I/O5L), U9.26 (GPA5)
/D13R: IC1.32 (I/O5R), J4.27
/D14L: IC1.23 (I/O6L), U9.27 (GPA6)
/D14R: IC1.33 (I/O6R), J4.26
/D15L: IC1.24 (I/O7L), U9.28 (GPA7)
/D15R: IC1.34 (I/O7R), J4.25
/MBINT: A1.12 (D9), J5.6
/MISO: A1.15 (MISO), J1.6
/MOSI: A1.14 (MOSI), J1.7
/RX1: A1.2 (RX1), J3.9
/SCK: A1.16 (SCK), J1.5
/SCL: A1.24 (SCL/A5), J6.4, J7.4, U8.12 (SCK), U9.12 (SCK)
/SDA: A1.23 (SDA/A4), J6.3, J7.3, U8.13 (SDA), U9.13 (SDA)
/SS_D10: A1.13 (D10), J1.8
/TX1: A1.1 (TX1), J3.10
GND: A1.4 (GND), A1.29 (GND), BT1.2 (-), C1.2, C2.2, C3.2, C4.2, C5.2, C6.2, C7.2, C8.2, C9.2, C10.2, C11.2, C12.2, C13.2, C14.2, C15.2, IC1.26 (GND), IC2.26 (GND), J1.4, J4.2, J5.13, J6.1, J6.MP, J7.1, J7.MP, R2.2, R3.2, R4.2, R5.2, R6.2, R7.2, SW1.1 (C), U1.8 (GND), U1.15 (E), U2.8 (GND), U2.15 (E), U3.8 (GND), U3.15 (E), U4.2 (GND), U5.2 (GND), U6.5 (I0b), U6.6 (I1b), U6.8 (GND), U6.10 (I1c), U6.11 (I0c), U6.15 (E), U7.4 (GND), U7.9 (PFI), U8.10 (VSS), U9.10 (VSS), U10.2 (GND), U11.2 (GND), U12.2 (GND)
unnamed: A1.11 (D8), D1.1 (K)
unnamed: A1.30 (VIN), D2.1 (K)
unnamed: JP1.1 (A), R2.1, U8.17 (A2)
unnamed: JP2.1 (A), R3.1, U9.17 (A2)
unnamed: JP3.1 (A), R4.1, U8.16 (A1)
unnamed: JP4.1 (A), R5.1, U9.16 (A1)
unnamed: JP5.1 (A), R6.1, U8.15 (A0)
unnamed: JP6.1 (A), R7.1, U9.15 (A0)
unnamed: R1.2, SW1.2 (B), U1.1 (S), U2.1 (S), U3.1 (S), U6.1 (S)
unnamed: U4.4 (Y), U6.2 (I0a)
unnamed: U5.4 (Y), U6.14 (I0d)
VCC: A1.27 (+5V), C1.1, C2.1, C3.1, C4.1, C5.1, C6.1, C7.1, C8.1, C9.1, C15.1, D2.2 (A), J1.1, J1.2, J4.1, J6.2, J7.2, JP1.2 (B), JP2.2 (B), JP3.2 (B), JP4.2 (B), JP5.2 (B), JP6.2 (B), R1.1, RN1.1 (common), U1.16 (VCC), U2.16 (VCC), U3.16 (VCC), U4.3 (IN0), U4.5 (VCC), U5.3 (IN0), U5.5 (VCC), U6.16 (VCC), U7.3 (VCC), U8.9 (VDD), U9.9 (VDD)
VCC_BATT: BT1.1 (+), U7.1 (VBATT)
VCC_BU: C10.1, C11.1, C12.1, C13.1, C14.1, IC1.52 (VCC), IC2.52 (VCC), U7.2 (VOUT), U10.1 (IN1), U10.5 (VCC), U11.1 (IN1), U11.5 (VCC), U12.1 (IN1), U12.5 (VCC)

Notes on the sheet:
Default I2C addr. = 0x26
These 3 SN74LVC1G97 are configured as 2-input OR-gates with one inverted input (Y = /IN2 OR IN0).
Default I2C addr. = 0x27
To Micro SD Card Breakout Board
SW1 Address translation enable On (2-1): Translation enabled (A12->A11, ... ,A1->A0) Off (2-3): Translation disabled (A11->A11, ... , A0->A0)
These 2 SN74LVC1G97 are configured as 2-input OR-gates (Y = IN1 OR IN2).
STEMMA/I2C Headers

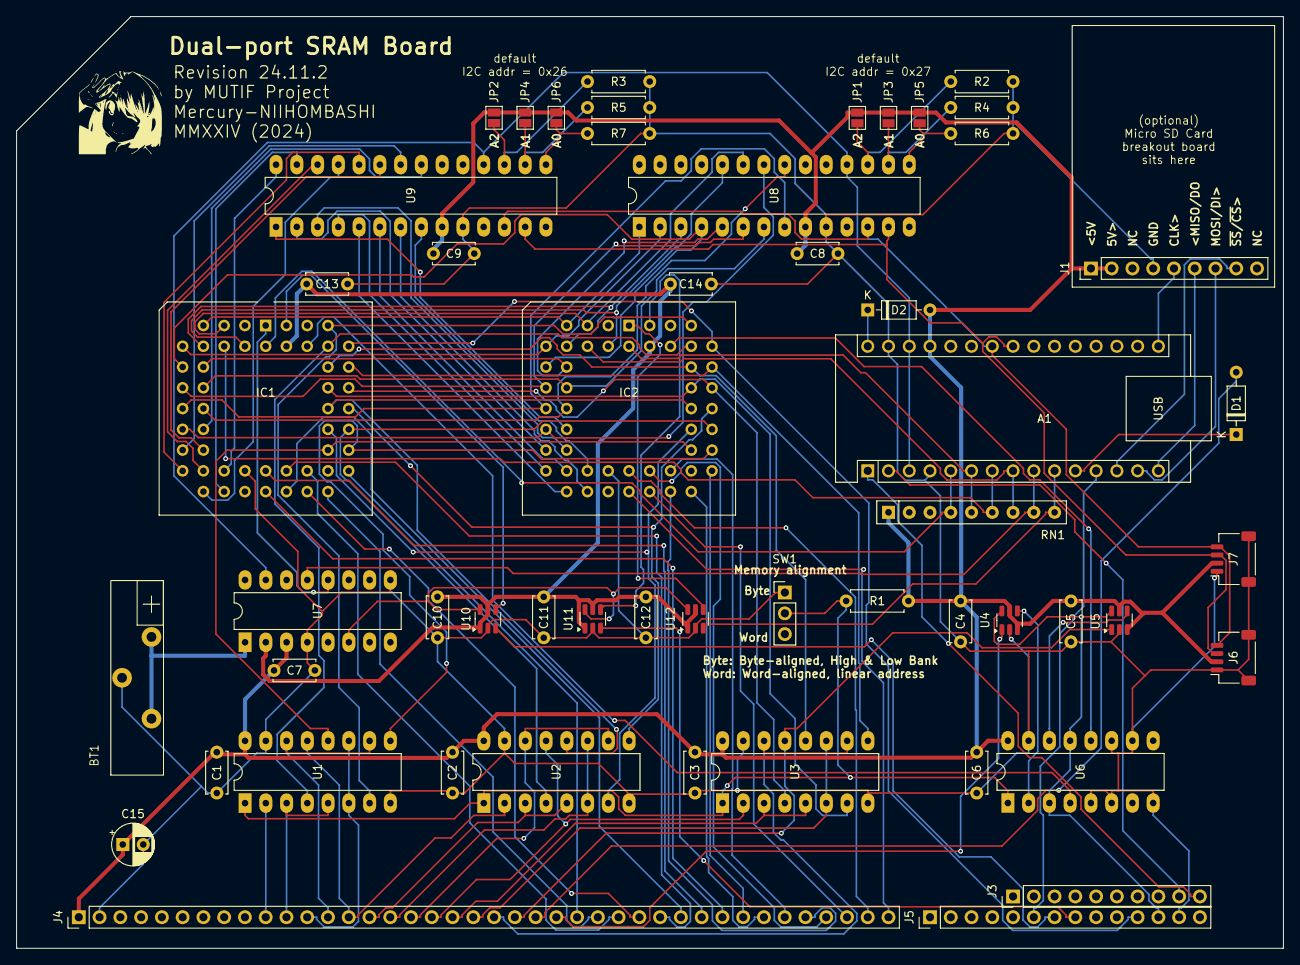
[picture p7: board dpram7134.kicad_pcb from above]

Board: 2 copper layers, 155.0 x 114.0 mm, 54 parts (0 on the bottom side), 113 nets.
