ja1umi/MUTIF1613Project/7segled/7segled.kicad_pcb

## KiCad design 7segled/7segled.kicad_pcb (2024-12-31)

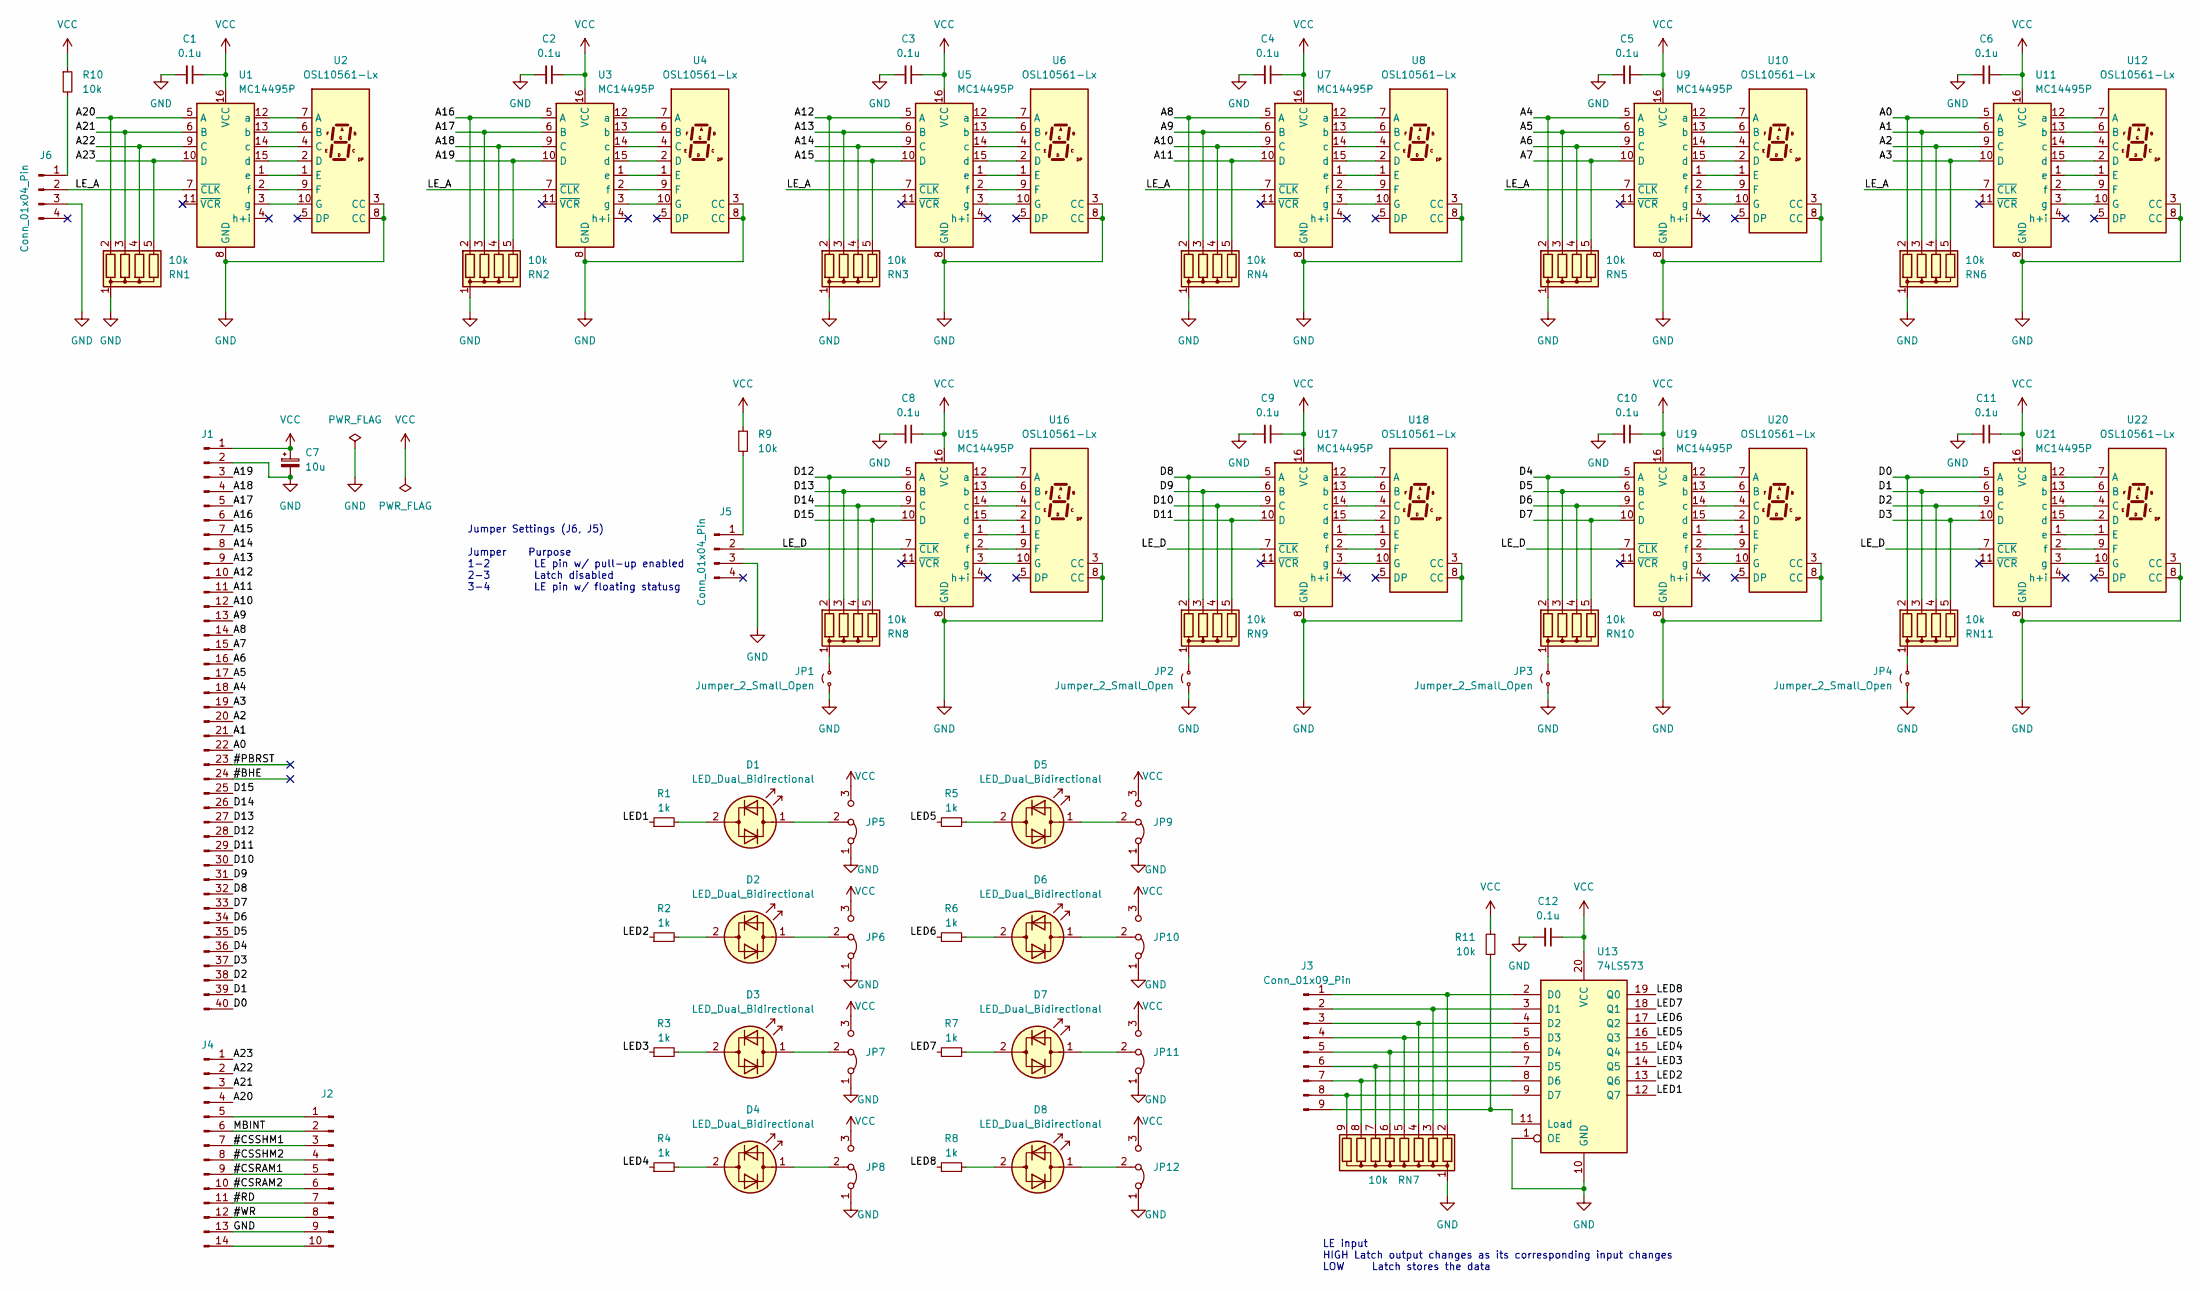
[picture p8: schematic 7segled.kicad_sch, 7-Segment LED Board]

Parts:
C1, C2, C3, C4, C5, C6, C8, C9, C10, C11, C12: 0.1u; C_Disc_D5.0mm_W2.5mm_P5.00mm
C7: 10u; CP_Radial_D5.0mm_P2.50mm
D1, D2, D3, D4, D5, D6, D7, D8: LED_Dual_Bidirectional; LED_D5.0mm
J1: Conn_01x40_Pin; PinHeader_1x40_P2.54mm_Vertical
J2: Conn_01x10_Pin; PinHeader_1x10_P2.54mm_Vertical
J3: Conn_01x09_Pin; PinHeader_1x09_P2.54mm_Vertical
J4: Conn_01x14_Pin; PinHeader_1x14_P2.54mm_Vertical
J5, J6: Conn_01x04_Pin; PinHeader_1x04_P2.54mm_Vertical
JP1, JP2, JP3, JP4: Jumper_2_Small_Open; PinHeader_1x02_P2.54mm_Vertical
JP5, JP6, JP7, JP8, JP9, JP10, JP11, JP12: Jumper_3_Bridged12; PinHeader_1x03_P2.54mm_Vertical
R1, R2, R3, R4, R5, R6, R7, R8: 1k; R_Axial_DIN0207_L6.3mm_D2.5mm_P7.62mm_Horizontal
R9, R10, R11: 10k; R_Axial_DIN0207_L6.3mm_D2.5mm_P7.62mm_Horizontal
RN1, RN2, RN3, RN4, RN5, RN6, RN8, RN9, RN10, RN11: 10k; R_Array_SIP5
RN7: 10k; R_Array_SIP9
U1, U3, U5, U7, U9, U11, U15, U17, U19, U21: MC14495P; DIP-16_W7.62mm_LongPads
U2, U4, U6, U8, U10, U12, U16, U18, U20, U22: OSL10561-Lx; D1X8K
U13: 74LS573; DIP-20_W7.62mm_LongPads

Connections:
/#BHE: J1.24
/#CSRAM1: J2.5, J4.9
/#CSRAM2: J2.6, J4.10
/#CSSHM1: J2.3, J4.7
/#CSSHM2: J2.4, J4.8
/#PBRST: J1.23
/#RD: J2.7, J4.11
/#WR: J2.8, J4.12
/A0: J1.22, RN6.2 (R1), U11.5 (A)
/A1: J1.21, RN6.3 (R2), U11.6 (B)
/A2: J1.20, RN6.4 (R3), U11.9 (C)
/A3: J1.19, RN6.5 (R4), U11.10 (D)
/A4: J1.18, RN5.2 (R1), U9.5 (A)
/A5: J1.17, RN5.3 (R2), U9.6 (B)
/A6: J1.16, RN5.4 (R3), U9.9 (C)
/A7: J1.15, RN5.5 (R4), U9.10 (D)
/A8: J1.14, RN4.2 (R1), U7.5 (A)
/A9: J1.13, RN4.3 (R2), U7.6 (B)
/A10: J1.12, RN4.4 (R3), U7.9 (C)
/A11: J1.11, RN4.5 (R4), U7.10 (D)
/A12: J1.10, RN3.2 (R1), U5.5 (A)
/A13: J1.9, RN3.3 (R2), U5.6 (B)
/A14: J1.8, RN3.4 (R3), U5.9 (C)
/A15: J1.7, RN3.5 (R4), U5.10 (D)
/A16: J1.6, RN2.2 (R1), U3.5 (A)
/A17: J1.5, RN2.3 (R2), U3.6 (B)
/A18: J1.4, RN2.4 (R3), U3.9 (C)
/A19: J1.3, RN2.5 (R4), U3.10 (D)
/A20: J4.4, RN1.2 (R1), U1.5 (A)
/A21: J4.3, RN1.3 (R2), U1.6 (B)
/A22: J4.2, RN1.4 (R3), U1.9 (C)
/A23: J4.1, RN1.5 (R4), U1.10 (D)
/D0: J1.40, RN11.2 (R1), U21.5 (A)
/D1: J1.39, RN11.3 (R2), U21.6 (B)
/D2: J1.38, RN11.4 (R3), U21.9 (C)
/D3: J1.37, RN11.5 (R4), U21.10 (D)
/D4: J1.36, RN10.2 (R1), U19.5 (A)
/D5: J1.35, RN10.3 (R2), U19.6 (B)
/D6: J1.34, RN10.4 (R3), U19.9 (C)
/D7: J1.33, RN10.5 (R4), U19.10 (D)
/D8: J1.32, RN9.2 (R1), U17.5 (A)
/D9: J1.31, RN9.3 (R2), U17.6 (B)
/D10: J1.30, RN9.4 (R3), U17.9 (C)
/D11: J1.29, RN9.5 (R4), U17.10 (D)
/D12: J1.28, RN8.2 (R1), U15.5 (A)
/D13: J1.27, RN8.3 (R2), U15.6 (B)
/D14: J1.26, RN8.4 (R3), U15.9 (C)
/D15: J1.25, RN8.5 (R4), U15.10 (D)
/LED1: R1.1, U13.12 (Q7)
/LED2: R2.1, U13.13 (Q6)
/LED3: R3.1, U13.14 (Q5)
/LED4: R4.1, U13.15 (Q4)
/LED5: R5.1, U13.16 (Q3)
/LED6: R6.1, U13.17 (Q2)
/LED7: R7.1, U13.18 (Q1)
/LED8: R8.1, U13.19 (Q0)
/LE_A: J6.2, U1.7 (~CLK), U3.7 (~CLK), U5.7 (~CLK), U7.7 (~CLK), U9.7 (~CLK), U11.7 (~CLK)
/LE_D: J5.2, U15.7 (~CLK), U17.7 (~CLK), U19.7 (~CLK), U21.7 (~CLK)
/MBINT: J2.2, J4.6
GND: C1.2, C2.2, C3.2, C4.2, C5.2, C6.2, C7.2, C8.2, C9.2, C10.2, C11.2, C12.2, J1.2, J2.9, J4.13, J5.3, J6.3, JP1.2 (B), JP2.2 (B), JP3.2 (B), JP4.2 (B), JP5.1 (A), JP6.1 (A), JP7.1 (A), JP8.1 (A), JP9.1 (A), JP10.1 (A), JP11.1 (A), JP12.1 (A), RN1.1 (common), RN2.1 (common), RN3.1 (common), RN4.1 (common), RN5.1 (common), RN6.1 (common), RN7.1 (common), U1.8 (GND), U2.3 (CC), U2.8 (CC), U3.8 (GND), U4.3 (CC), U4.8 (CC), U5.8 (GND), U6.3 (CC), U6.8 (CC), U7.8 (GND), U8.3 (CC), U8.8 (CC), U9.8 (GND), U10.3 (CC), U10.8 (CC), U11.8 (GND), U12.3 (CC), U12.8 (CC), U13.1 (OE), U13.10 (GND), U15.8 (GND), U16.3 (CC), U16.8 (CC), U17.8 (GND), U18.3 (CC), U18.8 (CC), U19.8 (GND), U20.3 (CC), U20.8 (CC), U21.8 (GND), U22.3 (CC), U22.8 (CC)
unnamed: D1.2 (AK), R1.2
unnamed: D1.1 (KA), JP5.2 (C)
unnamed: D2.2 (AK), R2.2
unnamed: D2.1 (KA), JP6.2 (C)
unnamed: D3.2 (AK), R3.2
unnamed: D3.1 (KA), JP7.2 (C)
unnamed: D4.2 (AK), R4.2
unnamed: D4.1 (KA), JP8.2 (C)
unnamed: D5.2 (AK), R5.2
unnamed: D5.1 (KA), JP9.2 (C)
unnamed: D6.2 (AK), R6.2
unnamed: D6.1 (KA), JP10.2 (C)
unnamed: D7.2 (AK), R7.2
unnamed: D7.1 (KA), JP11.2 (C)
unnamed: D8.2 (AK), R8.2
unnamed: D8.1 (KA), JP12.2 (C)
unnamed: J2.1, J4.5
unnamed: J2.10, J4.14
unnamed: J3.1, RN7.2 (R1), U13.2 (D0)
unnamed: J3.2, RN7.3 (R2), U13.3 (D1)
unnamed: J3.3, RN7.4 (R3), U13.4 (D2)
unnamed: J3.4, RN7.5 (R4), U13.5 (D3)
unnamed: J3.5, RN7.6 (R5), U13.6 (D4)
unnamed: J3.6, RN7.7 (R6), U13.7 (D5)
unnamed: J3.7, RN7.8 (R7), U13.8 (D6)
unnamed: J3.8, RN7.9 (R8), U13.9 (D7)
unnamed: J3.9, R11.2, U13.11 (Load)
unnamed: J5.1, R9.2
unnamed: J6.1, R10.2
unnamed: JP1.1 (A), RN8.1 (common)
unnamed: JP2.1 (A), RN9.1 (common)
unnamed: JP3.1 (A), RN10.1 (common)
unnamed: JP4.1 (A), RN11.1 (common)
unnamed: U1.12 (a), U2.7 (A)
unnamed: U1.13 (b), U2.6 (B)
unnamed: U1.14 (c), U2.4 (C)
unnamed: U1.15 (d), U2.2 (D)
unnamed: U1.1 (e), U2.1 (E)
unnamed: U1.2 (f), U2.9 (F)
unnamed: U1.3 (g), U2.10 (G)
unnamed: U3.12 (a), U4.7 (A)
unnamed: U3.13 (b), U4.6 (B)
unnamed: U3.14 (c), U4.4 (C)
unnamed: U3.15 (d), U4.2 (D)
unnamed: U3.1 (e), U4.1 (E)
unnamed: U3.2 (f), U4.9 (F)
unnamed: U3.3 (g), U4.10 (G)
unnamed: U5.12 (a), U6.7 (A)
unnamed: U5.13 (b), U6.6 (B)
unnamed: U5.14 (c), U6.4 (C)
unnamed: U5.15 (d), U6.2 (D)
unnamed: U5.1 (e), U6.1 (E)
unnamed: U5.2 (f), U6.9 (F)
unnamed: U5.3 (g), U6.10 (G)
unnamed: U7.12 (a), U8.7 (A)
unnamed: U7.13 (b), U8.6 (B)
unnamed: U7.14 (c), U8.4 (C)
unnamed: U7.15 (d), U8.2 (D)
unnamed: U7.1 (e), U8.1 (E)
unnamed: U7.2 (f), U8.9 (F)
unnamed: U7.3 (g), U8.10 (G)
unnamed: U9.12 (a), U10.7 (A)
unnamed: U9.13 (b), U10.6 (B)
unnamed: U9.14 (c), U10.4 (C)
unnamed: U9.15 (d), U10.2 (D)
unnamed: U9.1 (e), U10.1 (E)
unnamed: U9.2 (f), U10.9 (F)
unnamed: U9.3 (g), U10.10 (G)
unnamed: U11.12 (a), U12.7 (A)
unnamed: U11.13 (b), U12.6 (B)
unnamed: U11.14 (c), U12.4 (C)
unnamed: U11.15 (d), U12.2 (D)
unnamed: U11.1 (e), U12.1 (E)
unnamed: U11.2 (f), U12.9 (F)
unnamed: U11.3 (g), U12.10 (G)
unnamed: U15.12 (a), U16.7 (A)
unnamed: U15.13 (b), U16.6 (B)
unnamed: U15.14 (c), U16.4 (C)
unnamed: U15.15 (d), U16.2 (D)
unnamed: U15.1 (e), U16.1 (E)
unnamed: U15.2 (f), U16.9 (F)
unnamed: U15.3 (g), U16.10 (G)
unnamed: U17.12 (a), U18.7 (A)
unnamed: U17.13 (b), U18.6 (B)
unnamed: U17.14 (c), U18.4 (C)
unnamed: U17.15 (d), U18.2 (D)
unnamed: U17.1 (e), U18.1 (E)
unnamed: U17.2 (f), U18.9 (F)
unnamed: U17.3 (g), U18.10 (G)
unnamed: U19.12 (a), U20.7 (A)
unnamed: U19.13 (b), U20.6 (B)
unnamed: U19.14 (c), U20.4 (C)
unnamed: U19.15 (d), U20.2 (D)
unnamed: U19.1 (e), U20.1 (E)
unnamed: U19.2 (f), U20.9 (F)
unnamed: U19.3 (g), U20.10 (G)
unnamed: U21.12 (a), U22.7 (A)
unnamed: U21.13 (b), U22.6 (B)
unnamed: U21.14 (c), U22.4 (C)
unnamed: U21.15 (d), U22.2 (D)
unnamed: U21.1 (e), U22.1 (E)
unnamed: U21.2 (f), U22.9 (F)
unnamed: U21.3 (g), U22.10 (G)
VCC: C1.1, C2.1, C3.1, C4.1, C5.1, C6.1, C7.1, C8.1, C9.1, C10.1, C11.1, C12.1, J1.1, JP5.3 (B), JP6.3 (B), JP7.3 (B), JP8.3 (B), JP9.3 (B), JP10.3 (B), JP11.3 (B), JP12.3 (B), R9.1, R10.1, R11.1, U1.16 (VCC), U3.16 (VCC), U5.16 (VCC), U7.16 (VCC), U9.16 (VCC), U11.16 (VCC), U13.20 (VCC), U15.16 (VCC), U17.16 (VCC), U19.16 (VCC), U21.16 (VCC)

Notes on the sheet:
Jumper Settings (J6, J5) Jumper Purpose 1-2 LE pin w/ pull-up enabled 2-3 Latch disabled 3-4 LE pin w/ floating statusg
LE input HIGH Latch output changes as its corresponding input changes LOW Latch stores the data
