ja1umi/MUTIF1613Project/7segled/7segled.kicad_pcb

## KiCad design 7segled/7segled.kicad_pcb (continued)

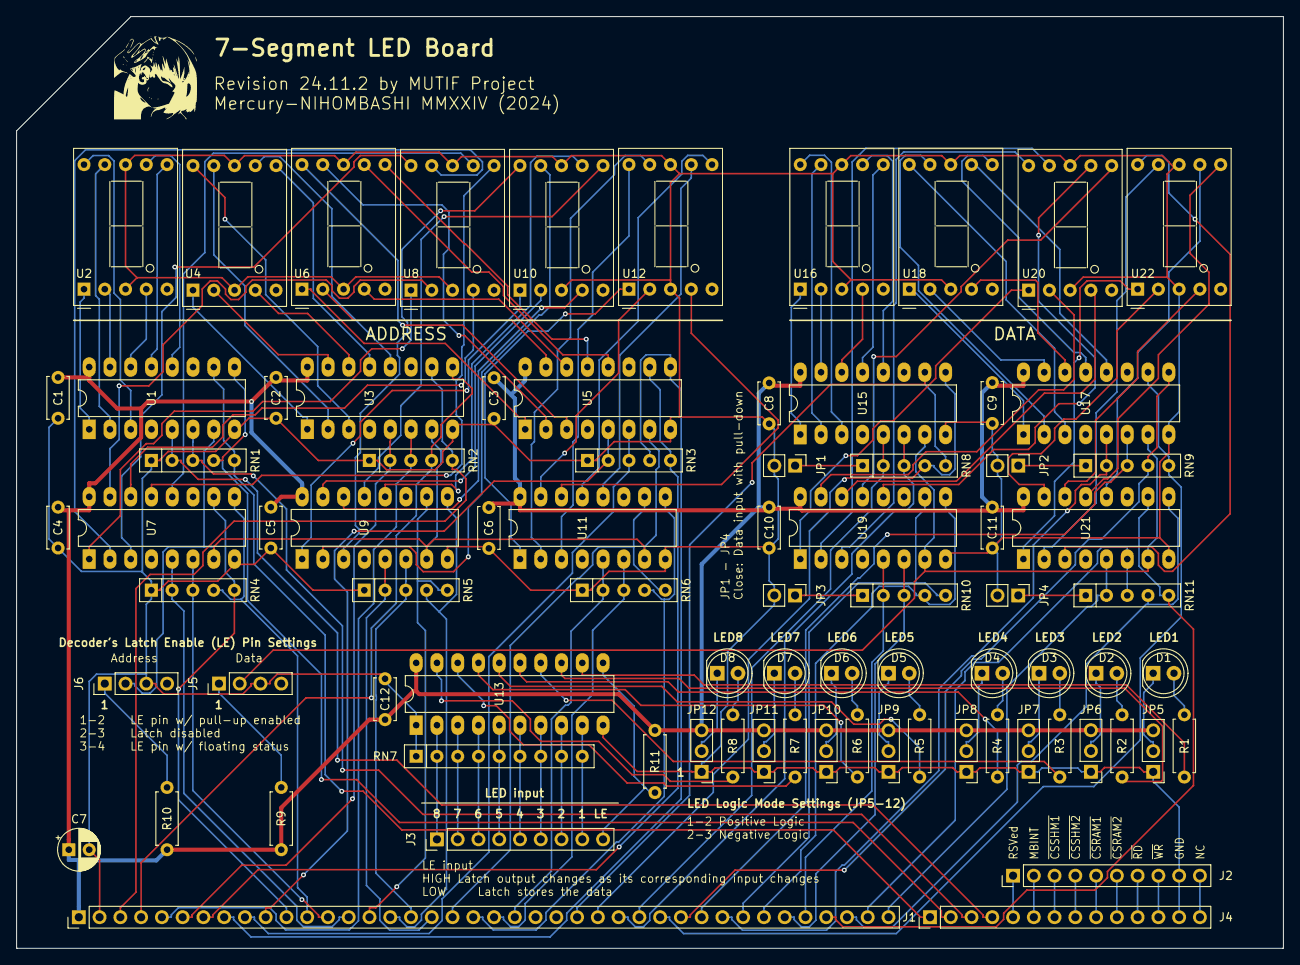
[picture p9: board 7segled.kicad_pcb from above]

Board: 2 copper layers, 155.0 x 114.0 mm, 81 parts (0 on the bottom side), 162 nets.
