ja1umi/MUTIF1613Project/mutif1613/mutif1613.kicad_pcb

## KiCad design mutif1613/mutif1613.kicad_pcb (2024-12-31)

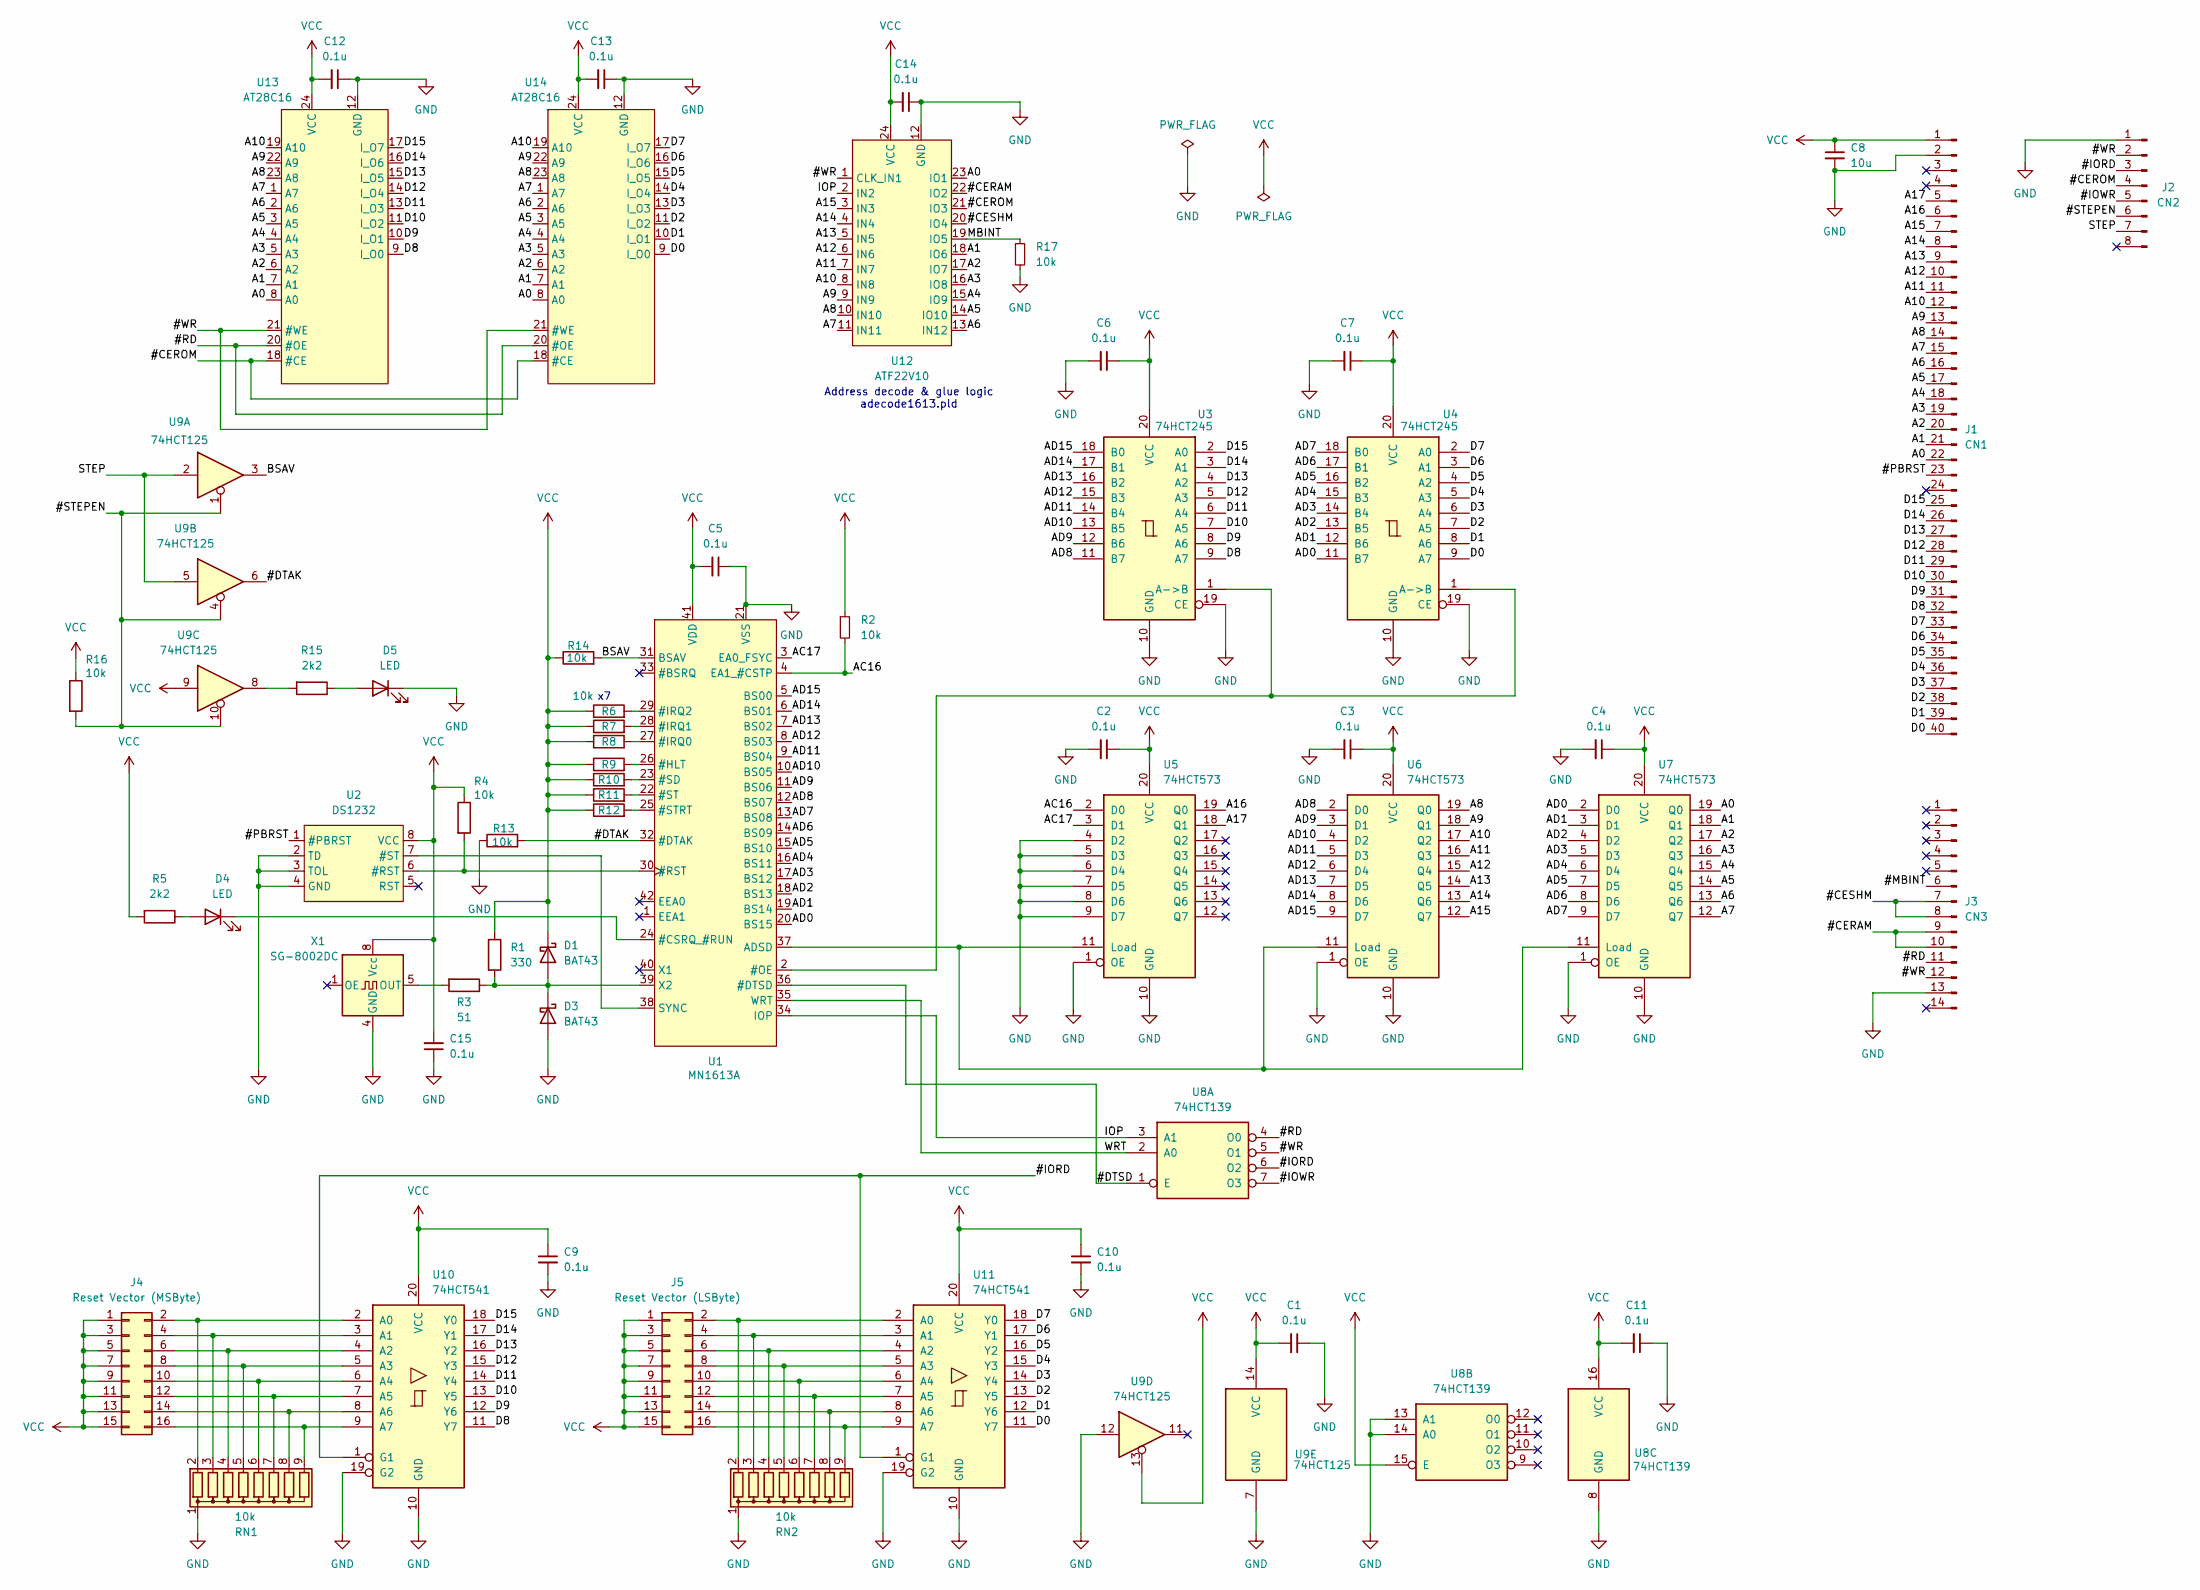
[picture p10: schematic mutif1613.kicad_sch, MUTIF-1613 CPU Board]

Parts:
C1, C2, C3, C4, C5, C6, C7, C9, C10, C11, C12, C13, C14, C15: 0.1u; C_Disc_D5.0mm_W2.5mm_P5.00mm
C8: 10u; CP_Radial_D5.0mm_P2.50mm
D1, D3: BAT43; D_DO-35_SOD27_P7.62mm_Horizontal
D4, D5: LED; LED_D3.0mm
J1: CN1; PinHeader_1x40_P2.54mm_Vertical
J2: CN2; PinHeader_1x08_P2.54mm_Vertical
J3: CN3; PinHeader_1x14_P2.54mm_Vertical
J4: Reset Vector (MSByte); PinHeader_2x08_P2.54mm_Vertical
J5: Reset Vector (LSByte); PinHeader_2x08_P2.54mm_Vertical
R1: 330; R_Axial_DIN0204_L3.6mm_D1.6mm_P7.62mm_Horizontal
R2, R4, R6, R7, R8, R9, R10, R11, R12, R13, R14, R16, R17: 10k; R_Axial_DIN0207_L6.3mm_D2.5mm_P7.62mm_Horizontal
R3: 51; R_Axial_DIN0207_L6.3mm_D2.5mm_P7.62mm_Horizontal
R5, R15: 2k2; R_Axial_DIN0207_L6.3mm_D2.5mm_P7.62mm_Horizontal
RN1, RN2: 10k; R_Array_SIP9
U1: MN1613A; DIP-42_W15.24mm_LongPads
U2: DS1232; DIP-8_W7.62mm_LongPads
U3, U4: 74HCT245; DIP-20_W7.62mm_LongPads
U5, U6, U7: 74HCT573; DIP-20_W7.62mm_LongPads
U8: 74HCT139; DIP-16_W7.62mm_LongPads
U9: 74HCT125; DIP-14_W7.62mm_LongPads
U10, U11: 74HCT541; DIP-20_W7.62mm_LongPads
U12: ATF22V10; DIP-24_W7.62mm_LongPads
U13, U14: AT28C16; DIP-24_W15.24mm_LongPads
X1: SG-8002DC; Oscillator_SeikoEpson_SG-8002DC

Connections:
/#CERAM: J3.9, J3.10, U12.22 (IO2)
/#CEROM: J2.4, U12.21 (IO3), U13.18 (#CE), U14.18 (#CE)
/#CESHM: J3.7, J3.8, U12.20 (IO4)
/#DTAK: R13.2, U1.32 (#DTAK), U9.6
/#DTSD: U1.36 (#DTSD), U8.1 (E)
/#IORD: J2.3, U8.6 (O2), U10.1 (G1), U11.1 (G1)
/#IOWR: J2.5, U8.7 (O3)
/#PBRST: J1.23, U2.1 (#PBRST)
/#RD: J3.11, U8.4 (O0), U13.20 (#OE), U14.20 (#OE)
/#STEPEN: J2.6, R16.2, U9.1, U9.4, U9.10
/#WR: J2.2, J3.12, U8.5 (O1), U12.1 (CLK_IN1), U13.21 (#WE), U14.21 (#WE)
/A0: J1.22, U7.19 (Q0), U12.23 (IO1), U13.8 (A0), U14.8 (A0)
/A1: J1.21, U7.18 (Q1), U12.18 (IO6), U13.7 (A1), U14.7 (A1)
/A2: J1.20, U7.17 (Q2), U12.17 (IO7), U13.6 (A2), U14.6 (A2)
/A3: J1.19, U7.16 (Q3), U12.16 (IO8), U13.5 (A3), U14.5 (A3)
/A4: J1.18, U7.15 (Q4), U12.15 (IO9), U13.4 (A4), U14.4 (A4)
/A5: J1.17, U7.14 (Q5), U12.14 (IO10), U13.3 (A5), U14.3 (A5)
/A6: J1.16, U7.13 (Q6), U12.13 (IN12), U13.2 (A6), U14.2 (A6)
/A7: J1.15, U7.12 (Q7), U12.11 (IN11), U13.1 (A7), U14.1 (A7)
/A8: J1.14, U6.19 (Q0), U12.10 (IN10), U13.23 (A8), U14.23 (A8)
/A9: J1.13, U6.18 (Q1), U12.9 (IN9), U13.22 (A9), U14.22 (A9)
/A10: J1.12, U6.17 (Q2), U12.8 (IN8), U13.19 (A10), U14.19 (A10)
/A11: J1.11, U6.16 (Q3), U12.7 (IN7)
/A12: J1.10, U6.15 (Q4), U12.6 (IN6)
/A13: J1.9, U6.14 (Q5), U12.5 (IN5)
/A14: J1.8, U6.13 (Q6), U12.4 (IN4)
/A15: J1.7, U6.12 (Q7), U12.3 (IN3)
/A16: J1.6, U5.19 (Q0)
/A17: J1.5, U5.18 (Q1)
/AC16: R2.2, U1.4 (EA1_#CSTP), U5.2 (D0)
/AC17: U1.3 (EA0_FSYC), U5.3 (D1)
/AD0: U1.20 (BS15), U4.11 (B7), U7.2 (D0)
/AD1: U1.19 (BS14), U4.12 (B6), U7.3 (D1)
/AD2: U1.18 (BS13), U4.13 (B5), U7.4 (D2)
/AD3: U1.17 (BS12), U4.14 (B4), U7.5 (D3)
/AD4: U1.16 (BS11), U4.15 (B3), U7.6 (D4)
/AD5: U1.15 (BS10), U4.16 (B2), U7.7 (D5)
/AD6: U1.14 (BS09), U4.17 (B1), U7.8 (D6)
/AD7: U1.13 (BS08), U4.18 (B0), U7.9 (D7)
/AD8: U1.12 (BS07), U3.11 (B7), U6.2 (D0)
/AD9: U1.11 (BS06), U3.12 (B6), U6.3 (D1)
/AD10: U1.10 (BS05), U3.13 (B5), U6.4 (D2)
/AD11: U1.9 (BS04), U3.14 (B4), U6.5 (D3)
/AD12: U1.8 (BS03), U3.15 (B3), U6.6 (D4)
/AD13: U1.7 (BS02), U3.16 (B2), U6.7 (D5)
/AD14: U1.6 (BS01), U3.17 (B1), U6.8 (D6)
/AD15: U1.5 (BS00), U3.18 (B0), U6.9 (D7)
/BSAV: R14.2, U1.31 (BSAV), U9.3
/D0: J1.40, U4.9 (A7), U11.11 (Y7), U14.9 (I_O0)
/D1: J1.39, U4.8 (A6), U11.12 (Y6), U14.10 (I_O1)
/D2: J1.38, U4.7 (A5), U11.13 (Y5), U14.11 (I_O2)
/D3: J1.37, U4.6 (A4), U11.14 (Y4), U14.13 (I_O3)
/D4: J1.36, U4.5 (A3), U11.15 (Y3), U14.14 (I_O4)
/D5: J1.35, U4.4 (A2), U11.16 (Y2), U14.15 (I_O5)
/D6: J1.34, U4.3 (A1), U11.17 (Y1), U14.16 (I_O6)
/D7: J1.33, U4.2 (A0), U11.18 (Y0), U14.17 (I_O7)
/D8: J1.32, U3.9 (A7), U10.11 (Y7), U13.9 (I_O0)
/D9: J1.31, U3.8 (A6), U10.12 (Y6), U13.10 (I_O1)
/D10: J1.30, U3.7 (A5), U10.13 (Y5), U13.11 (I_O2)
/D11: J1.29, U3.6 (A4), U10.14 (Y4), U13.13 (I_O3)
/D12: J1.28, U3.5 (A3), U10.15 (Y3), U13.14 (I_O4)
/D13: J1.27, U3.4 (A2), U10.16 (Y2), U13.15 (I_O5)
/D14: J1.26, U3.3 (A1), U10.17 (Y1), U13.16 (I_O6)
/D15: J1.25, U3.2 (A0), U10.18 (Y0), U13.17 (I_O7)
/IOP: U1.34 (IOP), U8.3 (A1), U12.2 (IN2)
/STEP: J2.7, U9.2, U9.5
/WRT: U1.35 (WRT), U8.2 (A0)
unnamed: D1.2 (A), D3.1 (K), R1.2, R3.1, U1.39 (X2)
unnamed: D4.2 (A), R5.1
unnamed: D4.1 (K), U1.24 (#CSRQ_#RUN)
unnamed: D5.2 (A), R15.1
unnamed: J4.2, RN1.2 (R1), U10.2 (A0)
unnamed: J4.4, RN1.3 (R2), U10.3 (A1)
unnamed: J4.6, RN1.4 (R3), U10.4 (A2)
unnamed: J4.8, RN1.5 (R4), U10.5 (A3)
unnamed: J4.10, RN1.6 (R5), U10.6 (A4)
unnamed: J4.12, RN1.7 (R6), U10.7 (A5)
unnamed: J4.14, RN1.8 (R7), U10.8 (A6)
unnamed: J4.16, RN1.9 (R8), U10.9 (A7)
unnamed: J5.2, RN2.2 (R1), U11.2 (A0)
unnamed: J5.4, RN2.3 (R2), U11.3 (A1)
unnamed: J5.6, RN2.4 (R3), U11.4 (A2)
unnamed: J5.8, RN2.5 (R4), U11.5 (A3)
unnamed: J5.10, RN2.6 (R5), U11.6 (A4)
unnamed: J5.12, RN2.7 (R6), U11.7 (A5)
unnamed: J5.14, RN2.8 (R7), U11.8 (A6)
unnamed: J5.16, RN2.9 (R8), U11.9 (A7)
unnamed: R15.2, U9.8
unnamed: R9.2, U1.26 (#HLT)
unnamed: R8.2, U1.27 (#IRQ0)
unnamed: R7.2, U1.28 (#IRQ1)
unnamed: R6.2, U1.29 (#IRQ2)
unnamed: U1.2 (#OE), U3.1 (A->B), U4.1 (A->B)
unnamed: R4.2, U1.30 (#RST), U2.6 (#RST)
unnamed: R10.2, U1.23 (#SD)
unnamed: R11.2, U1.22 (#ST)
unnamed: R12.2, U1.25 (#STRT)
unnamed: U1.37 (ADSD), U5.11 (Load), U6.11 (Load), U7.11 (Load)
unnamed: U1.38 (SYNC), U2.7 (#ST)
unnamed: R3.2, X1.5 (OUT)

Notes on the sheet:
Address decode & glue logic adecode1613.pld

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
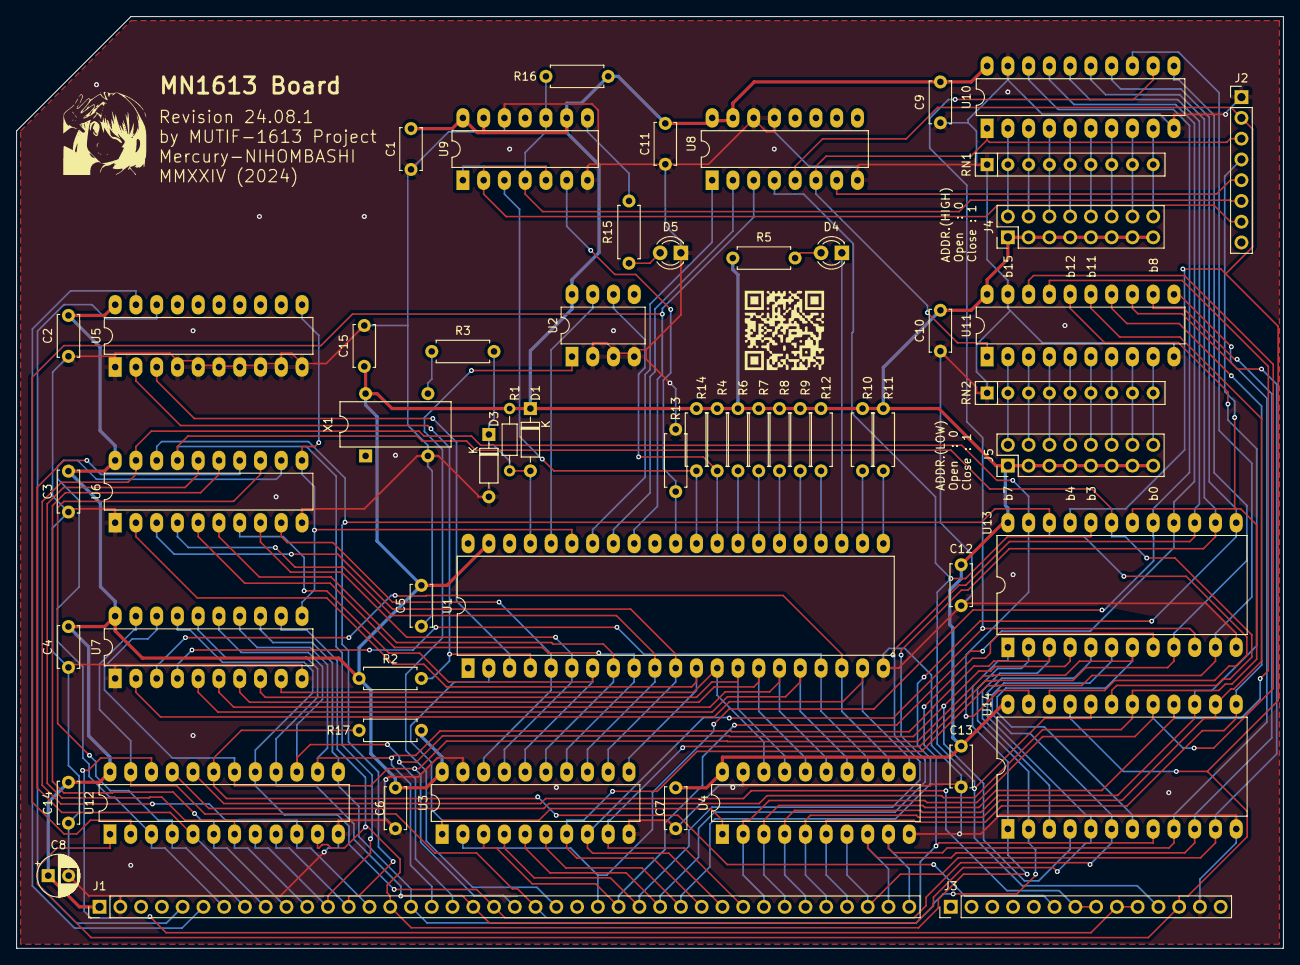
[picture p11: board mutif1613.kicad_pcb from above]

Board: 2 copper layers, 155.0 x 114.0 mm, 60 parts (0 on the bottom side), 103 nets.

Other parts of the board:
G1: LOGO; QR_GitHub_MUTIF1613
G2: LOGO; silk_icon
